tollsimy/LAITS-HW/Images/Screenshot_20220718_162311.png

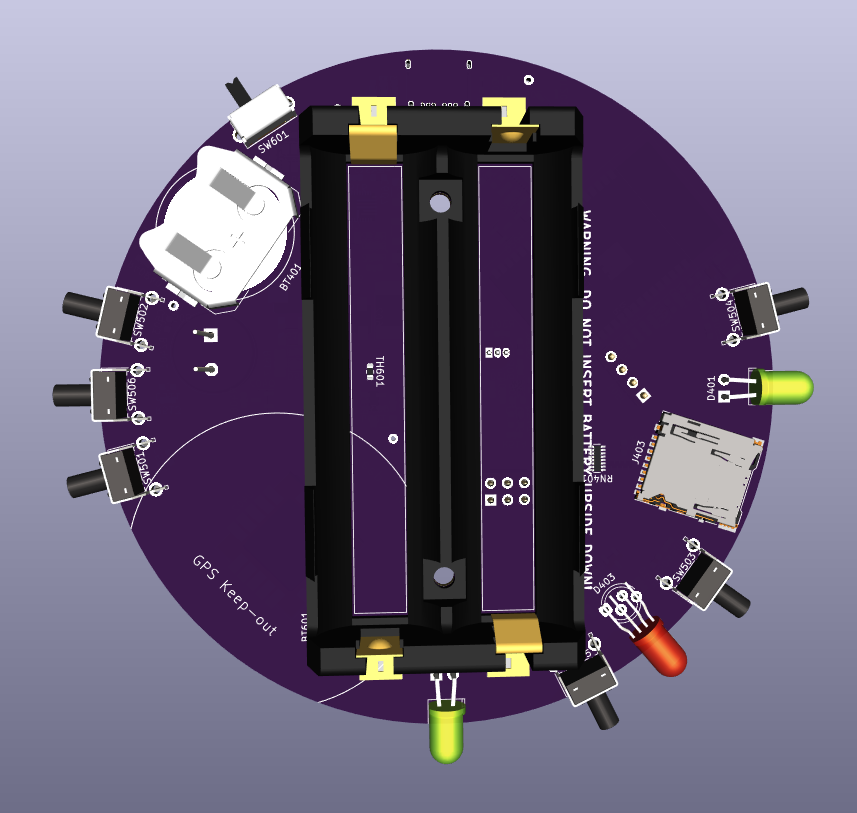
Images/Screenshot_20220718_162311.png
