tollsimy/LAITS-HW/datasheets/MAX_Priority_screen.png

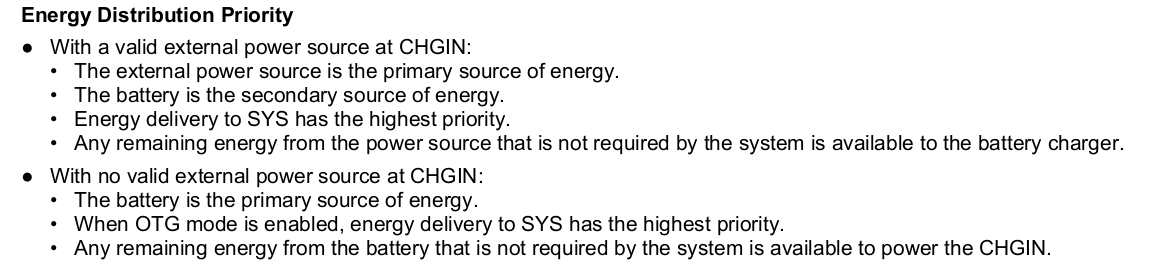
datasheets/MAX_Priority_screen.png
