tollsimy/LAITS-HW/datasheets/SX1503 screen 2.png

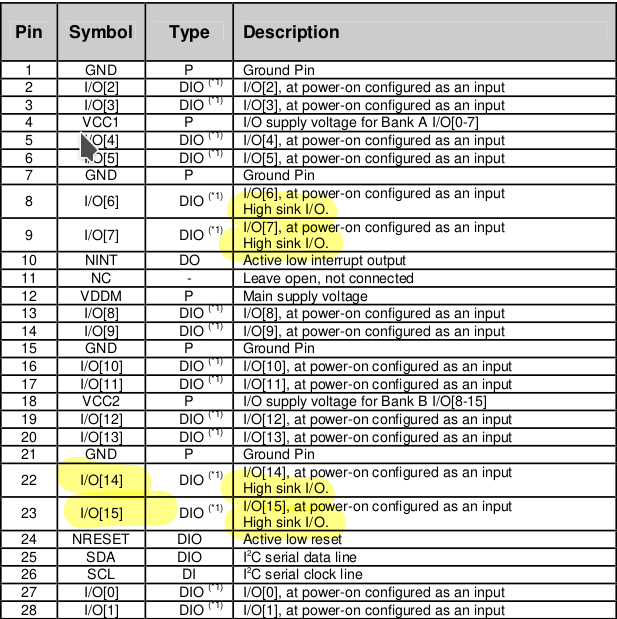
datasheets/SX1503 screen 2.png
