tollsimy/LAITS-HW/datasheets/SX1503 screen.png

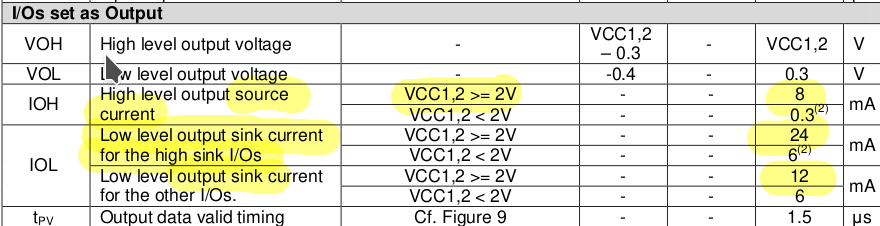
datasheets/SX1503 screen.png
