tollsimy/LAITS-HW/Images/Screenshot_20220715_111906.png

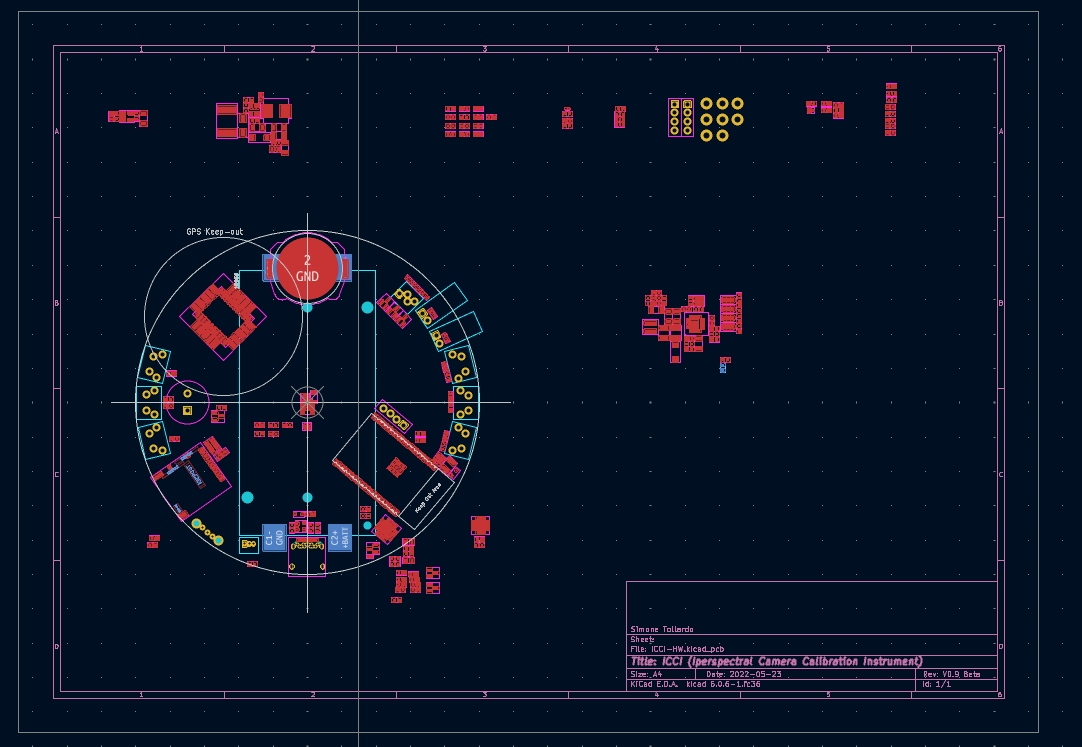
Images/Screenshot_20220715_111906.png
