tollsimy/LAITS-HW/Images/Screenshot_20220715_111938.png

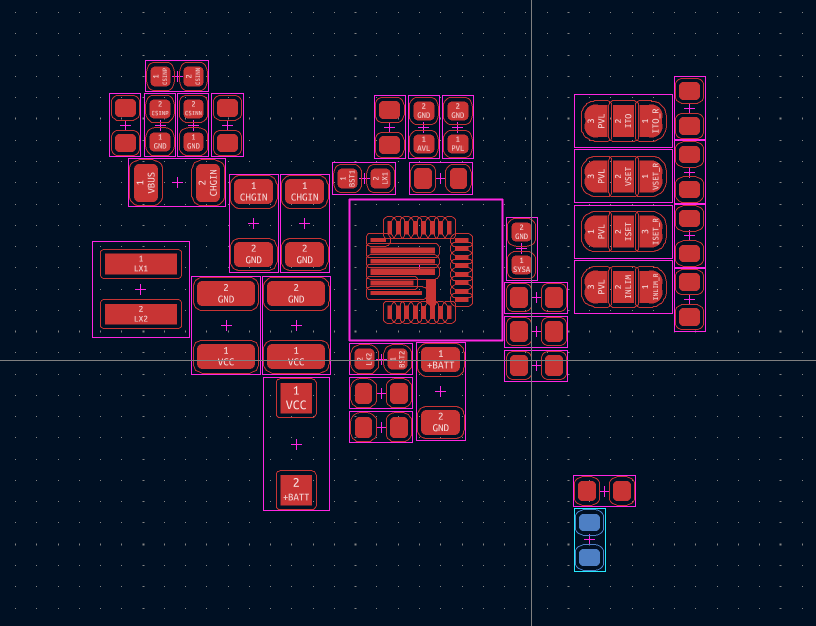
Images/Screenshot_20220715_111938.png
