tollsimy/LAITS-HW/Images/Screenshot_20220715_112000.png

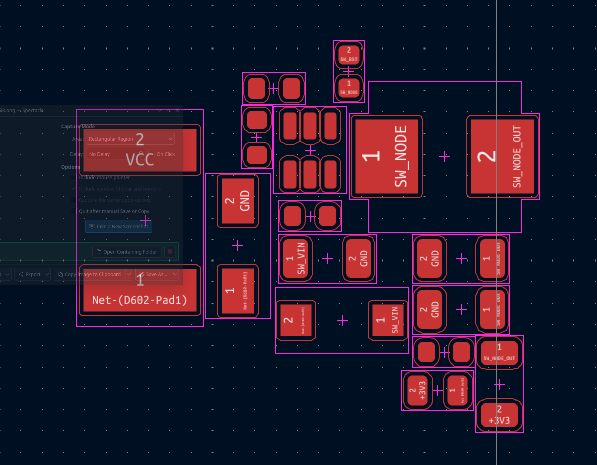
Images/Screenshot_20220715_112000.png
