tollsimy/LAITS-HW/Images/Screenshot_20220715_112012.png

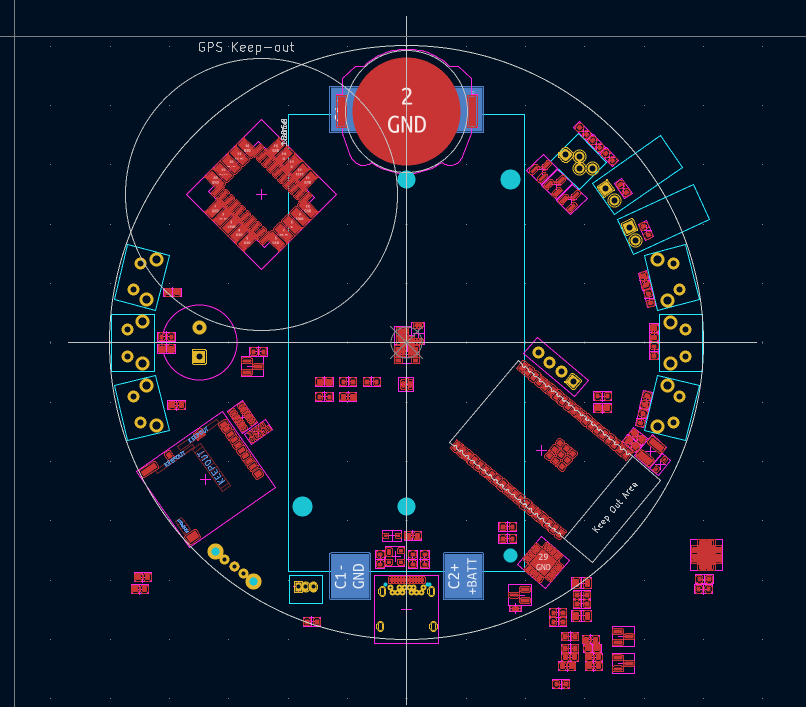
Images/Screenshot_20220715_112012.png
