tollsimy/LAITS-HW/Images/Screenshot_20220718_162223.png

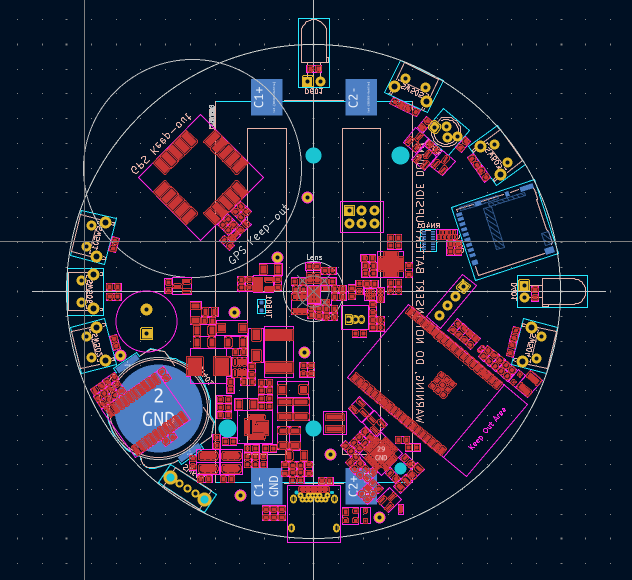
Images/Screenshot_20220718_162223.png
