tollsimy/LAITS-HW/Images/Screenshot_20220718_162258.png

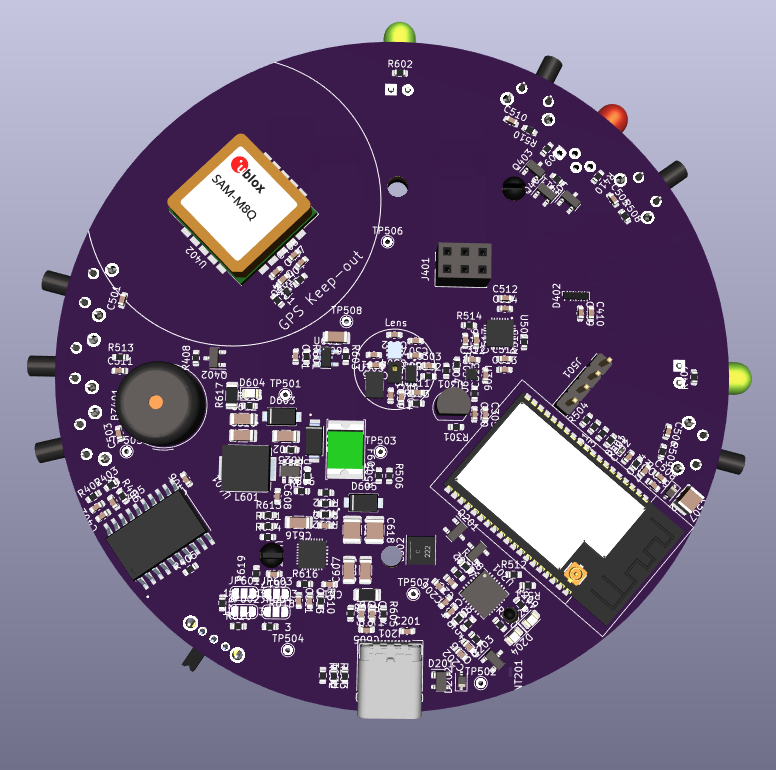
Images/Screenshot_20220718_162258.png
