tollsimy/LAITS-HW/Images/Screenshot_20220722_200650.png

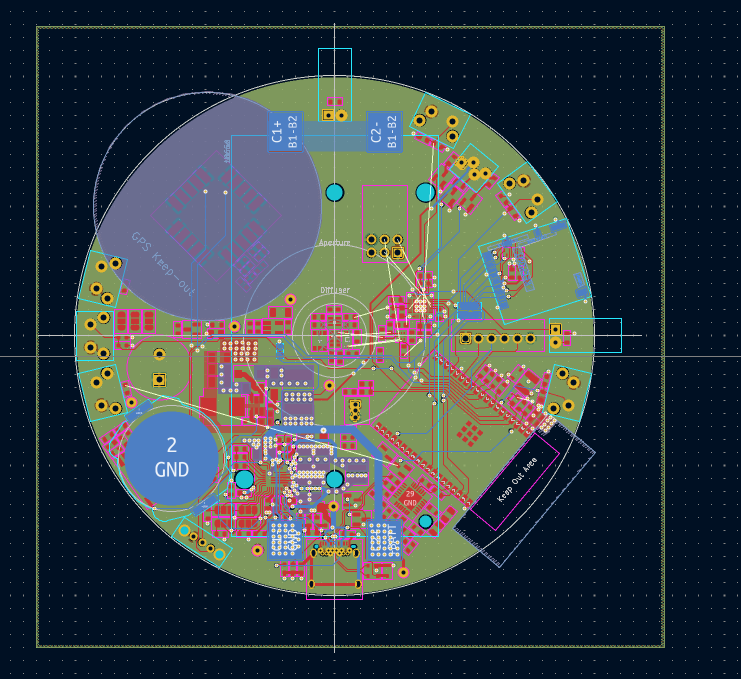
Images/Screenshot_20220722_200650.png
