tollsimy/LAITS-HW/Images/Screenshot_20220724_180053.png

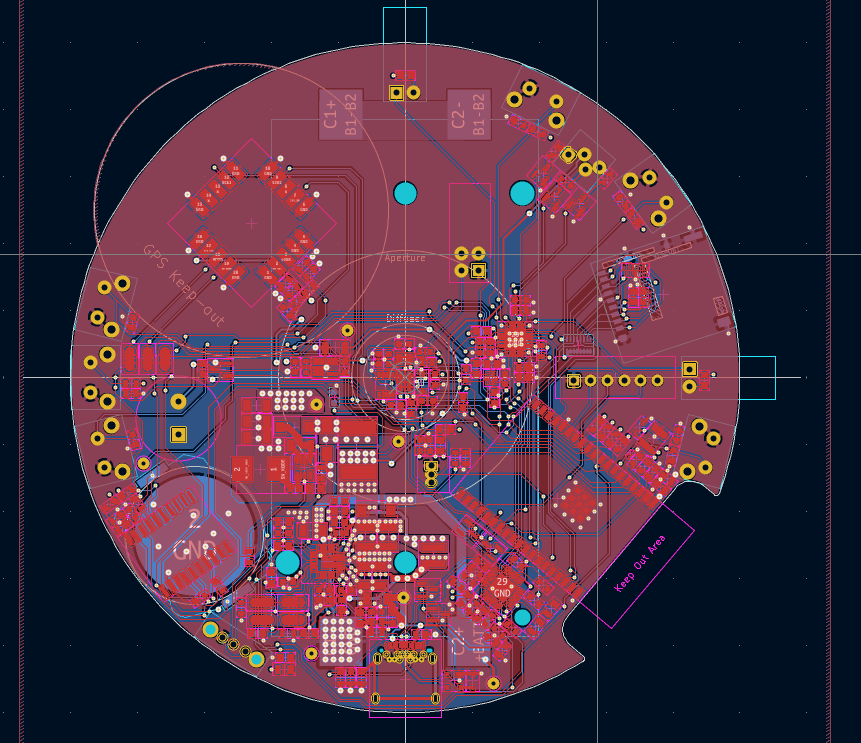
Images/Screenshot_20220724_180053.png
