tollsimy/LAITS-HW/Images/Screenshot_20220724_180108.png

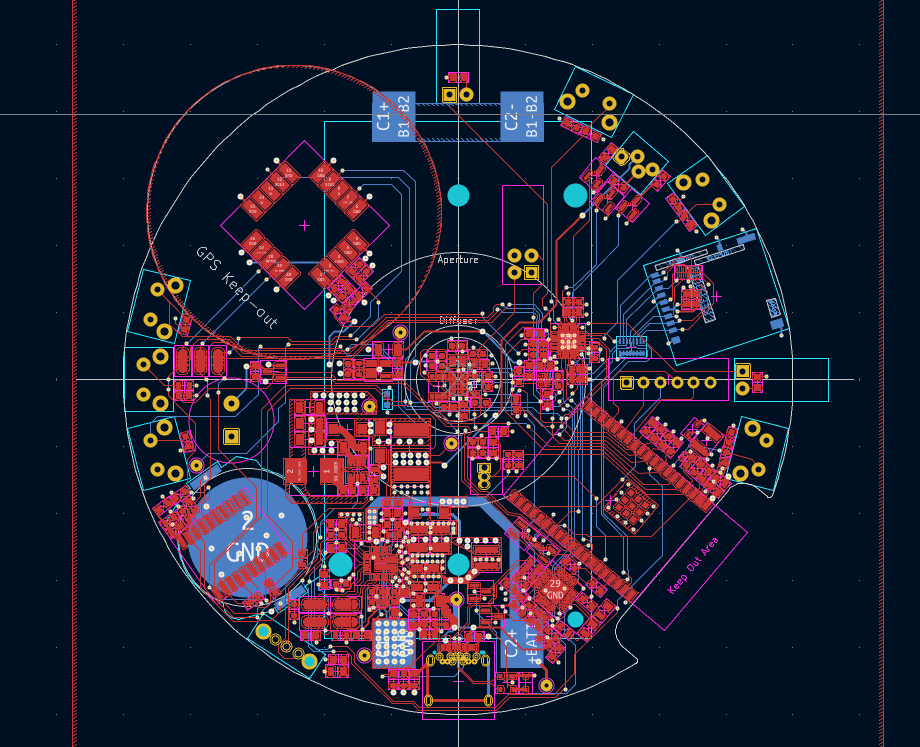
Images/Screenshot_20220724_180108.png
