tollsimy/LAITS-HW/Images/Screenshot_20220725_200332.png

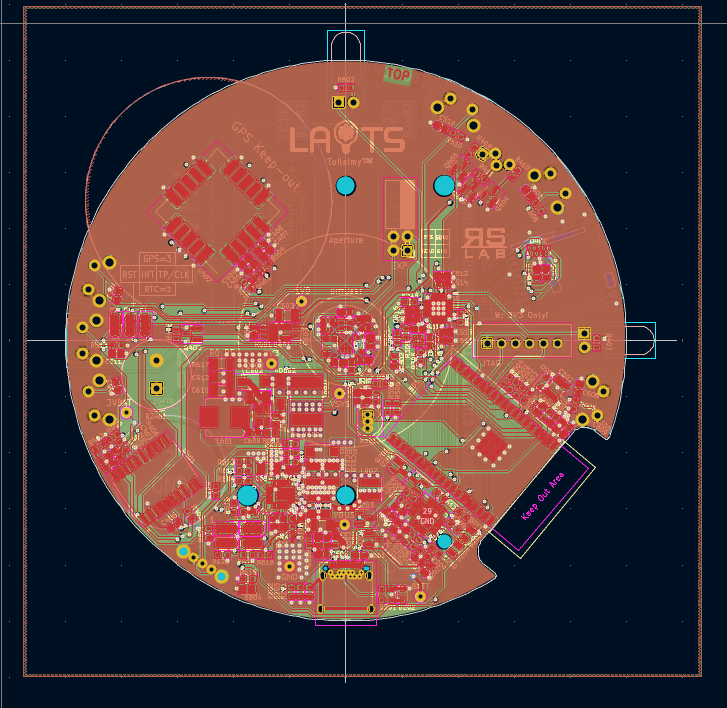
Images/Screenshot_20220725_200332.png
