tollsimy/LAITS-HW/Images/Screenshot_20220725_200348.png

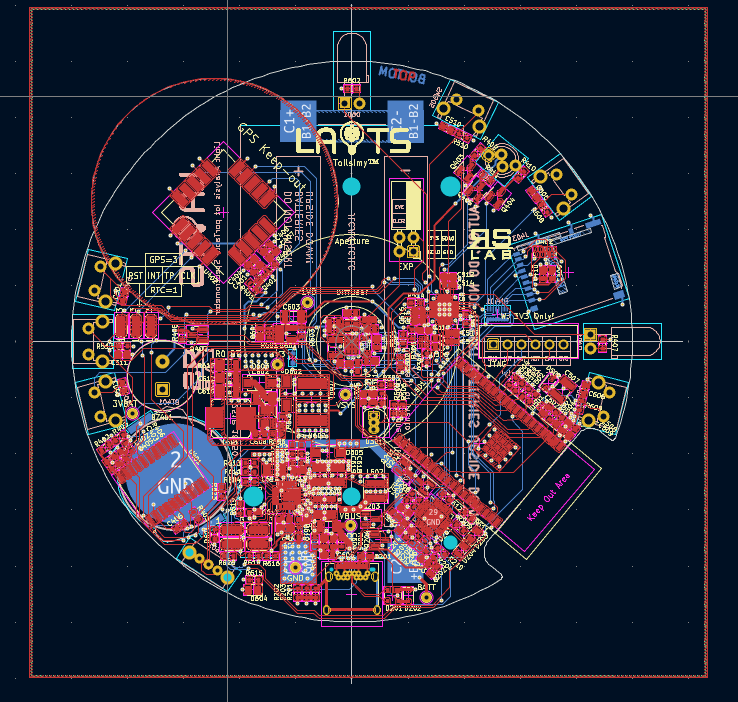
Images/Screenshot_20220725_200348.png
