tollsimy/LAITS-HW/LAITS-HW/LAITS_Edge_Cuts_round.dxf

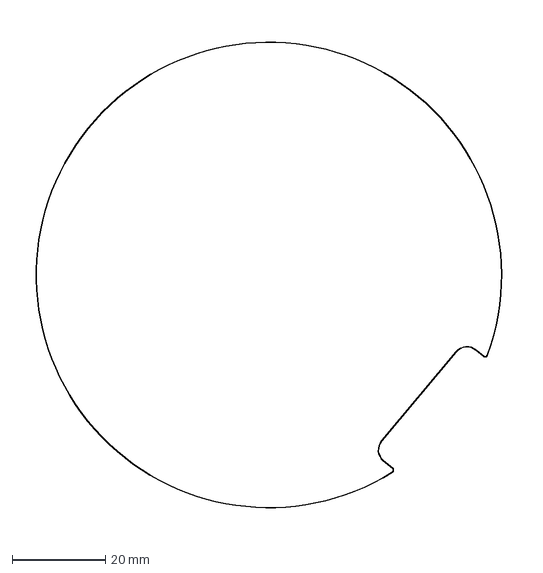
[picture p16: CAD file, 2022-07-25]
LAITS-HW/LAITS_Edge_Cuts_round.dxf
109.6 x 110.9 mm
