tollsimy/LAITS-HW/LAITS-HW/axies.dxf

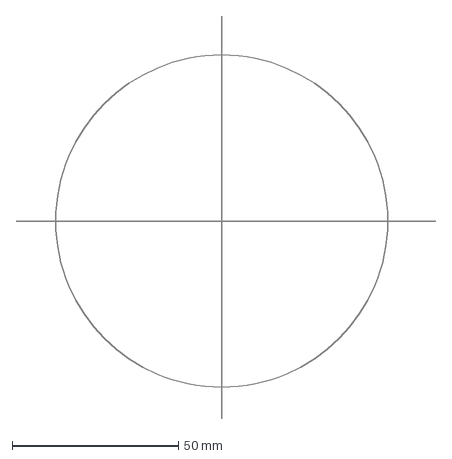
[picture p17: CAD file, 2022-07-15]
LAITS-HW/axies.dxf
126.3 x 121.2 mm
