tollsimy/LAITS-HW/Project Outputs/JLCPCB Instructions/Screenshot_20220727_115843.png

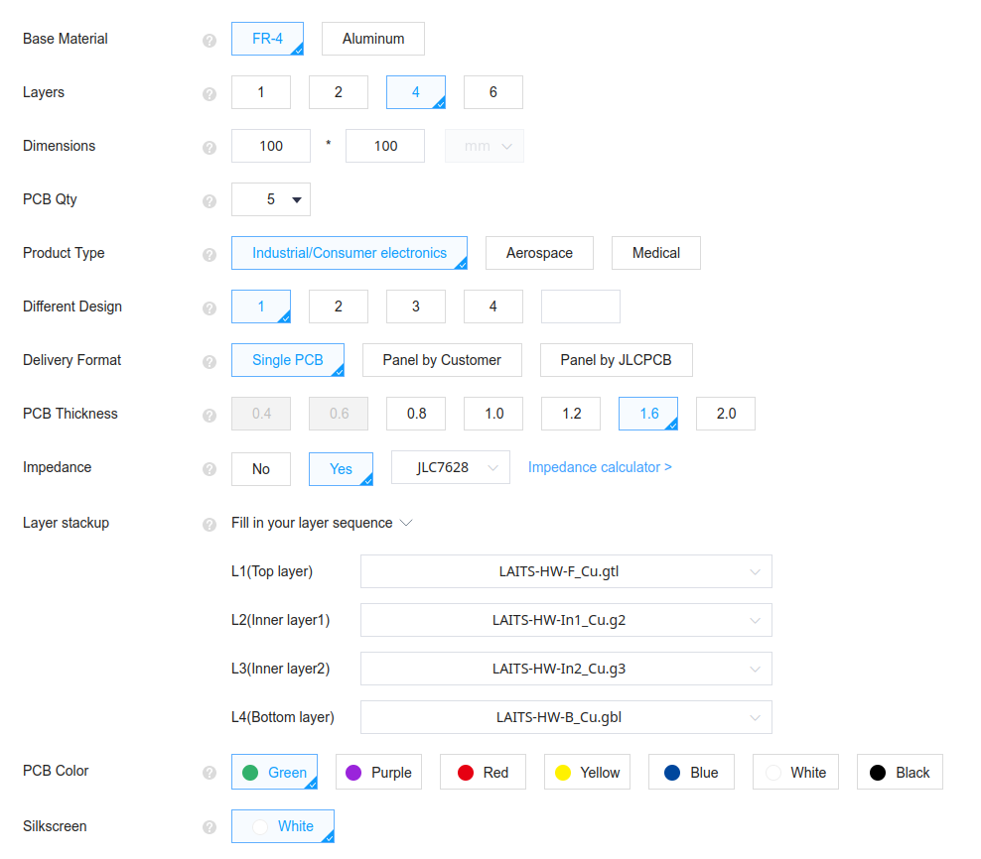
Project Outputs/JLCPCB Instructions/Screenshot_20220727_115843.png
