tollsimy/LAITS-HW/Project Outputs/JLCPCB Instructions/Screenshot_20220727_120037.png

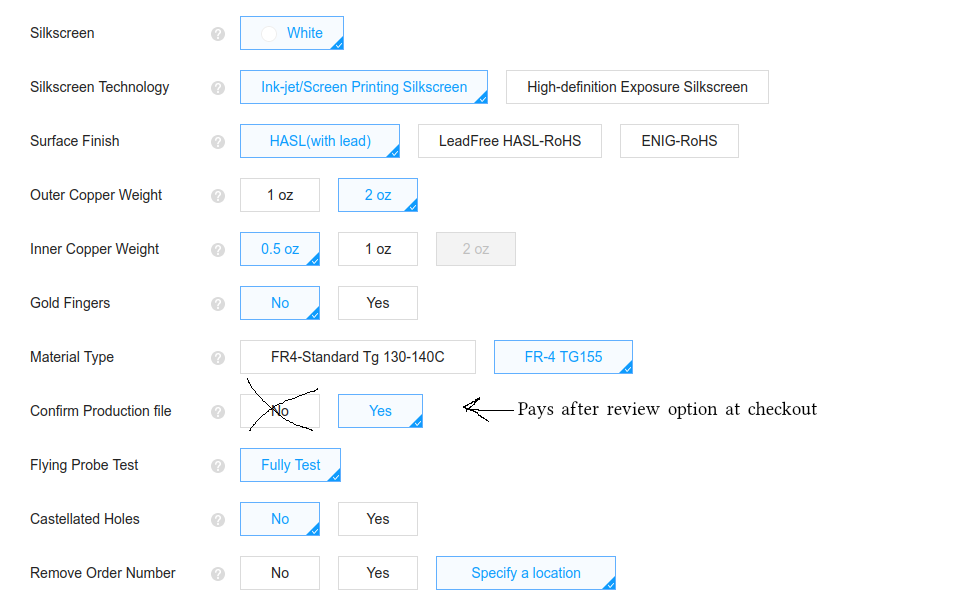
Project Outputs/JLCPCB Instructions/Screenshot_20220727_120037.png
