tollsimy/LAITS-HW/Project Outputs/JLCPCB Instructions/Screenshot_20220727_121014.png

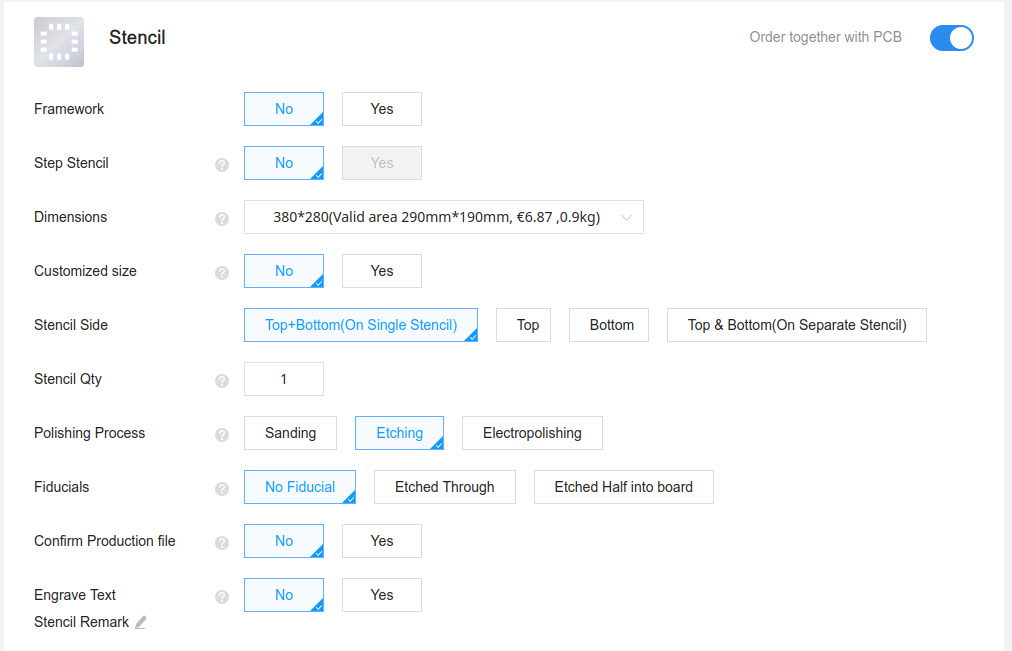
Project Outputs/JLCPCB Instructions/Screenshot_20220727_121014.png
