tollsimy/LAITS-HW/Project Outputs/LAITS-HW.pdf

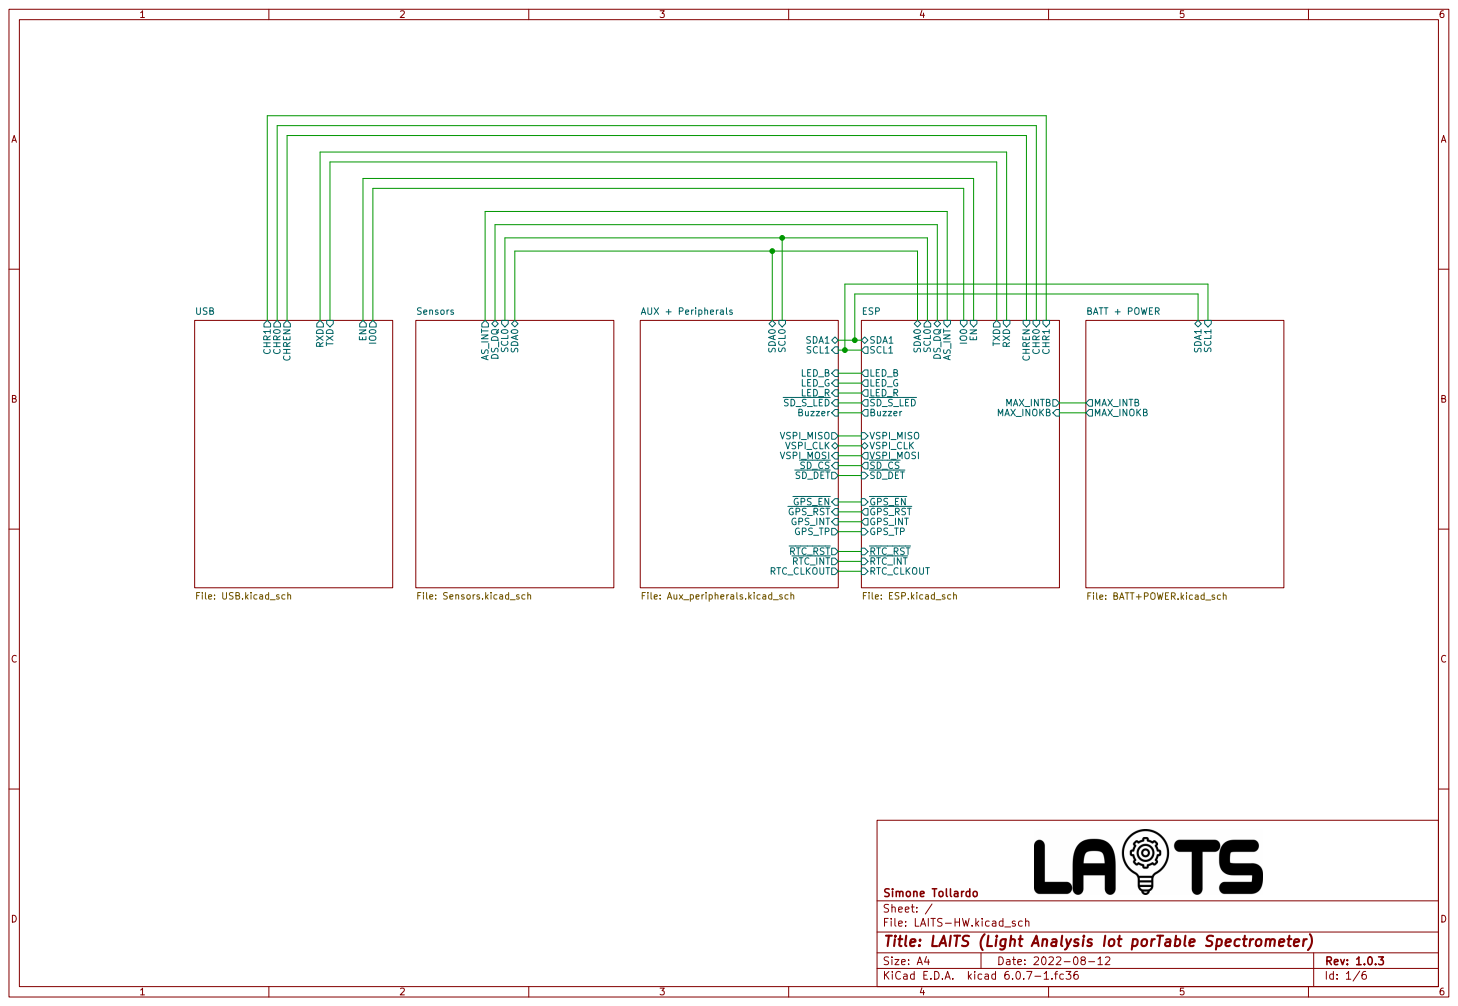
[picture p21: page 1]

AUX + Peripherals

BATT + POWER

File: LAITS-HW.kicad_sch Sheet: / Simone Tollardo

Id: 1/6 Title: LAITS (Light Analysis Iot porTable Spectrometer)

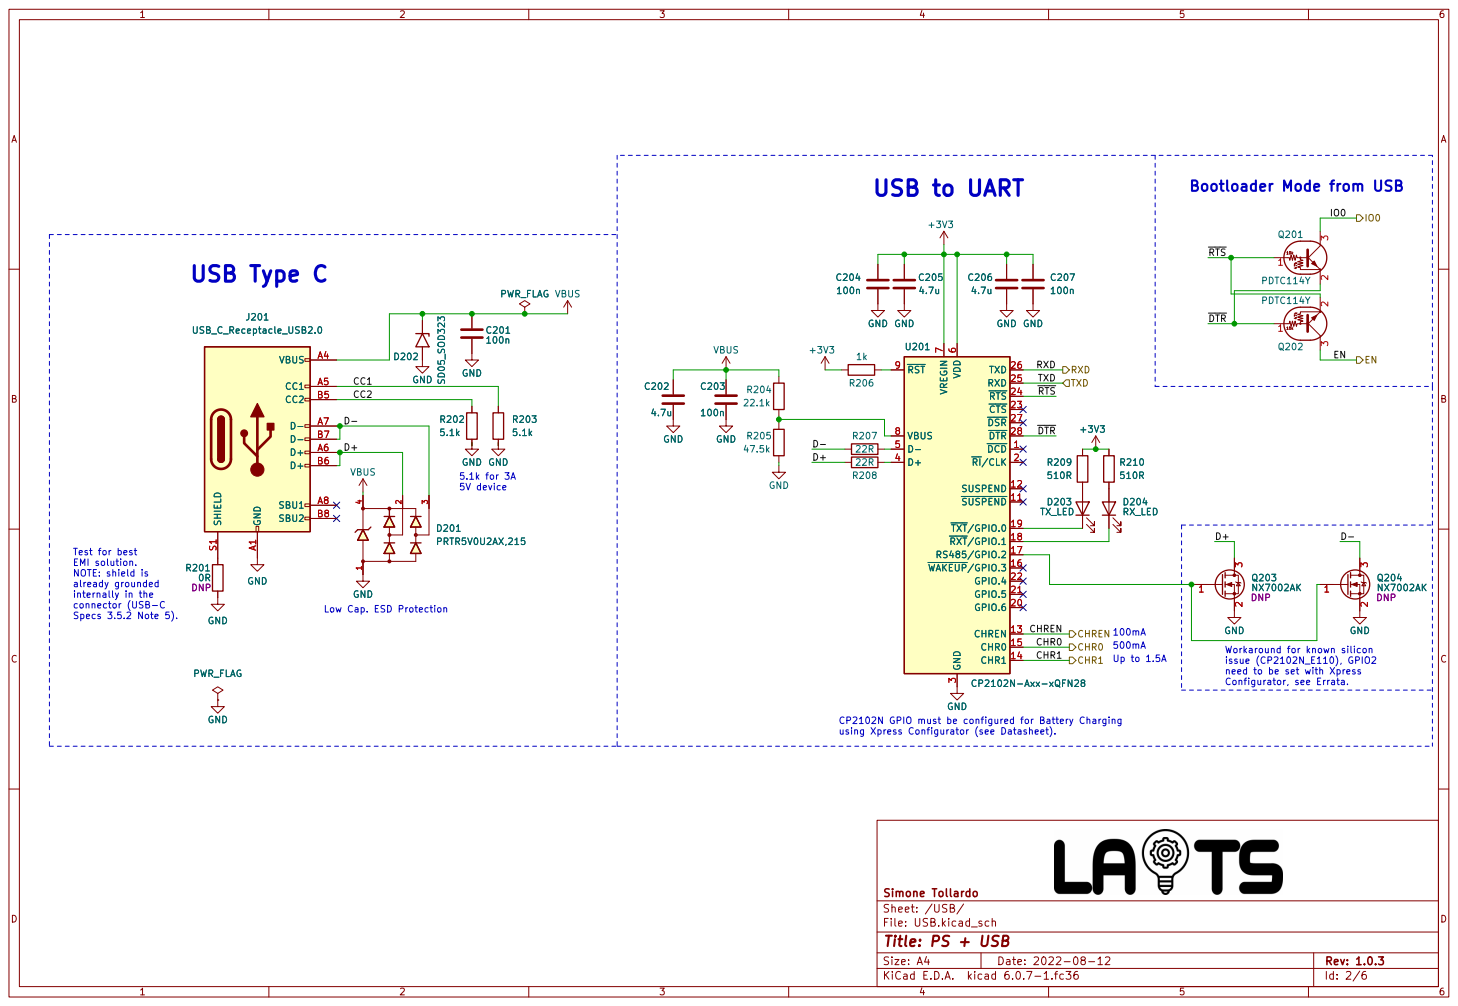
[picture p22: page 2]

Configurator, see Errata. Test for best EMI solution. NOTE: shield is already grounded

Low Cap. ESD Protection

issue (CP2102N_E110), GPIO2
need to be set with Xpress

CP2102N GPIO must be configured for Battery Charging
using Xpress Configurator (see Datasheet).

File: USB.kicad_sch Sheet: /USB/ Simone Tollardo

Id: 2/6 Title: PS + USB

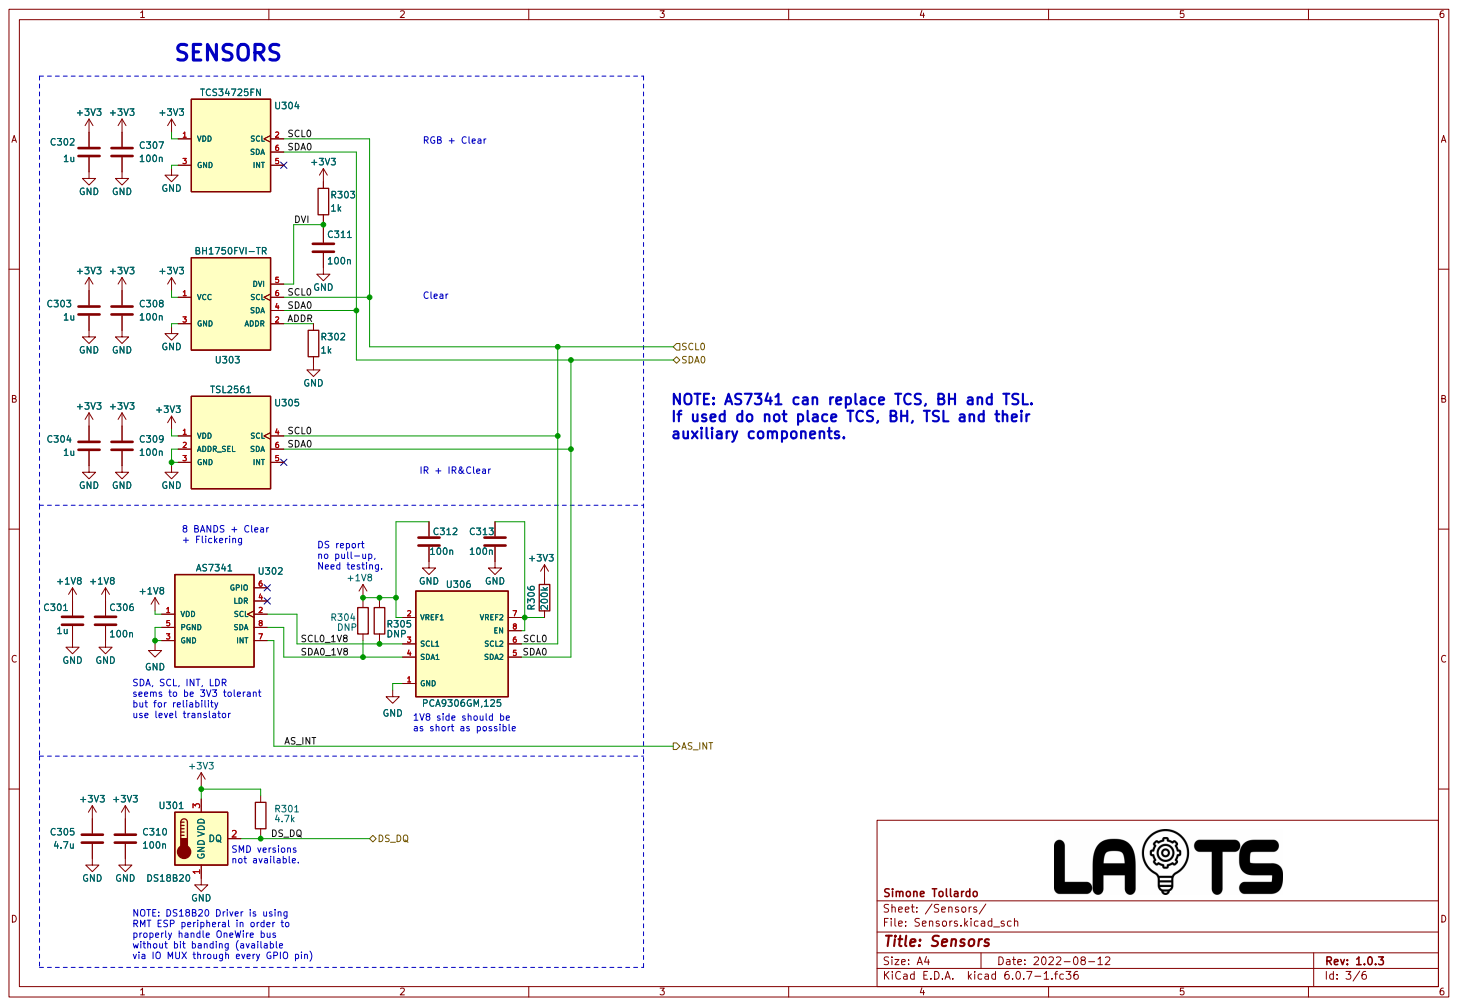
[picture p23: page 3]

IR + IR&Clear Clear RGB + Clear 8 BANDS + Clear + Flickering SDA, SCL, INT, LDR

NOTE: AS7341 can replace TCS, BH and TSL.
If used do not place TCS, BH, TSL and their
auxiliary components.

as short as possible

File: Sensors.kicad_sch Sheet: /Sensors/ Simone Tollardo GND

RMT ESP peripheral in order to
properly handle OneWire bus
without bit banding (available

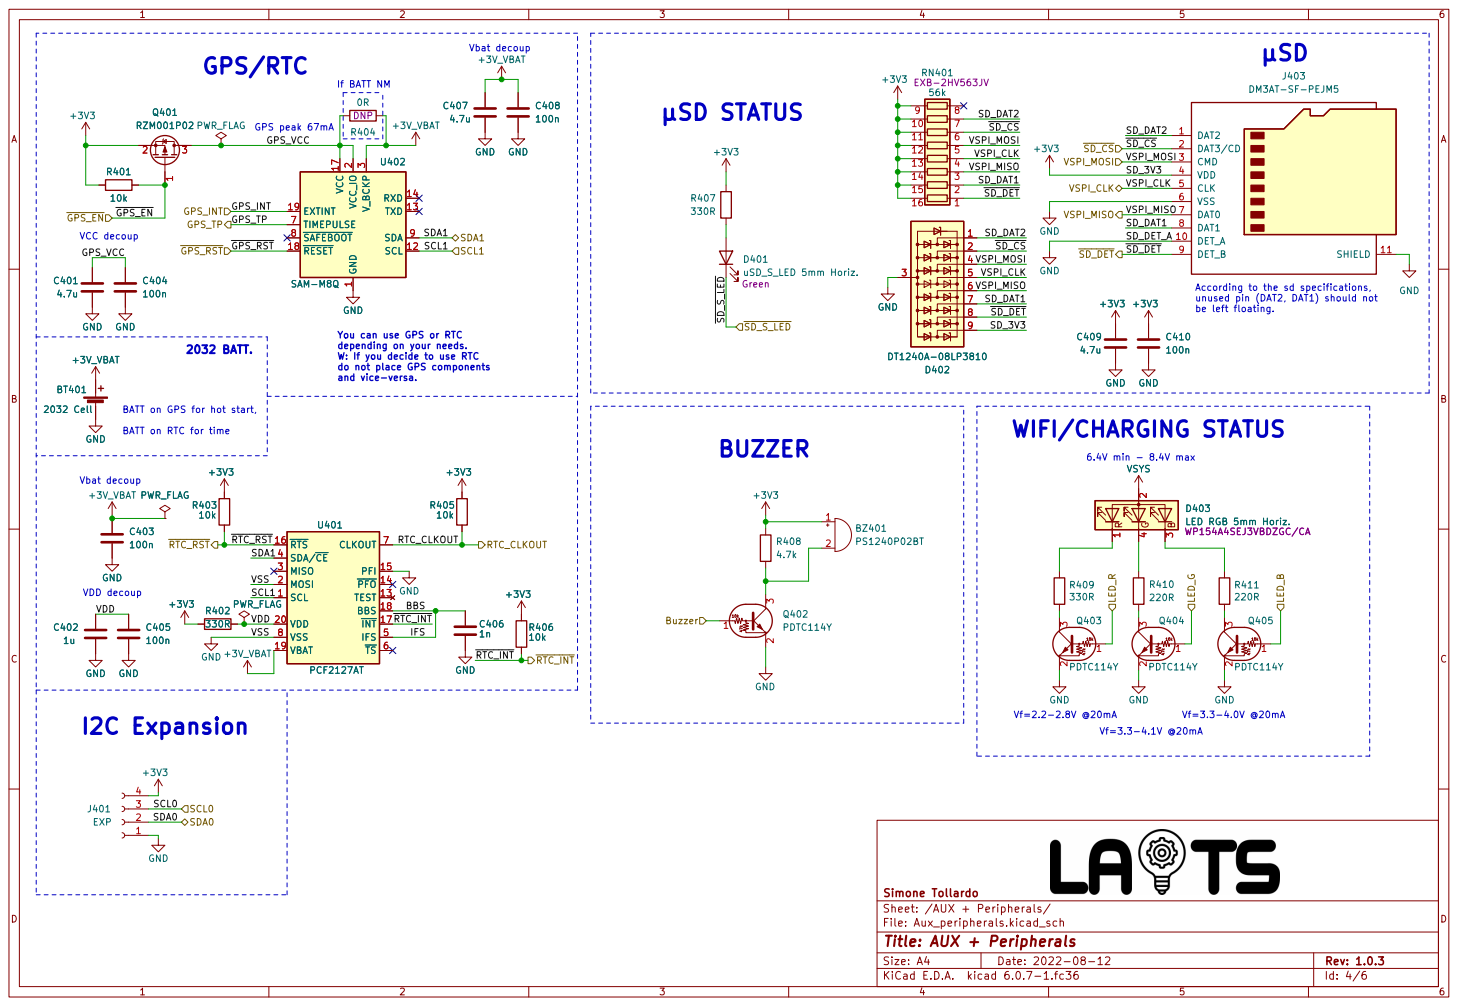
[picture p24: page 4]

3 TIMEPULSE 7 ~{SAFEBOOT} 8 SDA 9 GND GND

3 TIMEPULSE 7 ~{SAFEBOOT} 8 SDA 9 U402 SAM-M8Q

1 SCL 12 TXD 13 RXD VCC 14 17

Sheet: /AUX + Peripherals/ Simone Tollardo GND

unused pin (DAT2, DAT1) should not
be left floating.

depending on your needs.
W: If you decide to use RTC
do not place GPS components and vice-versa.

LED RGB 5mm Horiz. WP154A4SEJ3VBDZGC/CA R411

File: Aux_peripherals.kicad_sch
Id: 4/6 Title: AUX + Peripherals

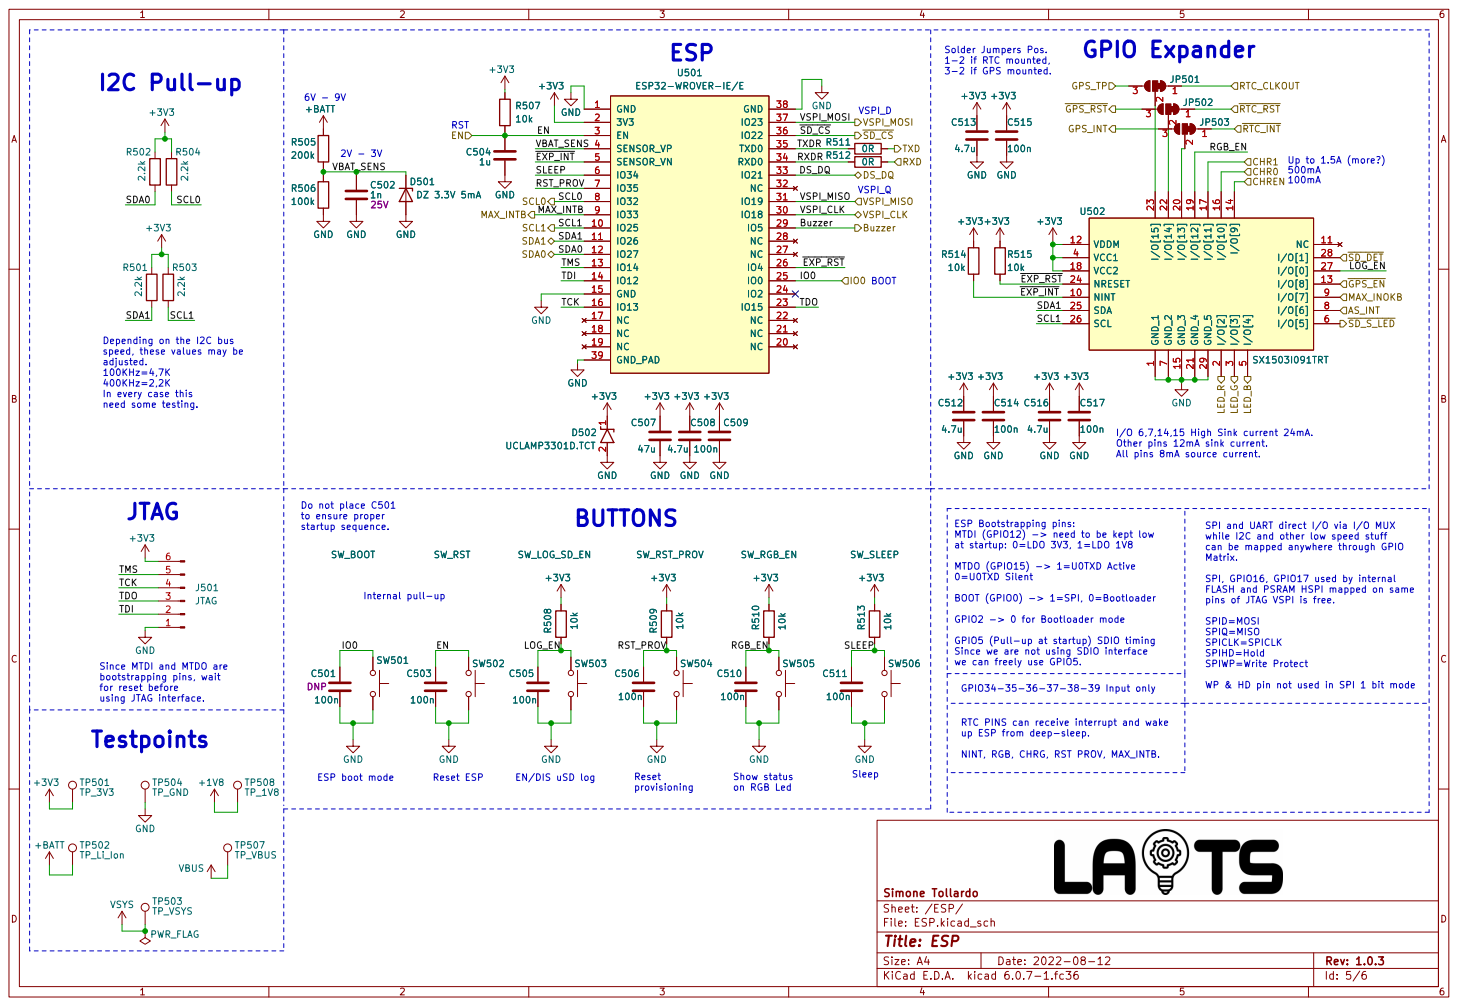
[picture p25: page 5]

Depending on the I2C bus
speed, these values may be
adjusted. 100KHz=4,7K

400KHz=2,2K
In every case this

I/O 6,7,14,15 High Sink current 24mA.
Other pins 12mA sink current.
All pins 8mA source current.

Do not place C501
to ensure proper startup sequence.

ESP Bootstrapping pins:
MTDI (GPIO12) -> need to be kept low
at startup: 0=LDO 3V3, 1=LDO 1V8

can be mapped anywhere through GPIO Matrix. SPI, GPIO16, GPIO17 used by internal

MTDO (GPIO15) -> 1=U0TXD Active
0=U0TXD Silent BOOT (GPIO0) -> 1=SPI, 0=Bootloader GPIO2 -> 0 for Bootloader mode GPIO5 (Pull-up at startup) SDIO timing

FLASH and PSRAM HSPI mapped on same
pins of JTAG VSPI is free. SPID=MOSI SPIQ=MISO

SPICLK=SPICLK
SPIHD=Hold SPIWP=Write Protect WP & HD pin not used in SPI 1 bit mode

Since we are not using SDIO interface

Since MTDI and MTDO are
bootstrapping pins, wait
for reset before
using JTAG interface.
Testpoints

RTC PINS can receive interrupt and wake up ESP from deep-sleep. NINT, RGB, CHRG, RST PROV, MAX_INTB.

+3V3 | TP502 TP_Li_Ion TP501 TP_3V3 +BATT | TP503 TP_VSYS PWR_FLAG

Show status on RGB Led Reset provisioning

File: ESP.kicad_sch Sheet: /ESP/ Simone Tollardo

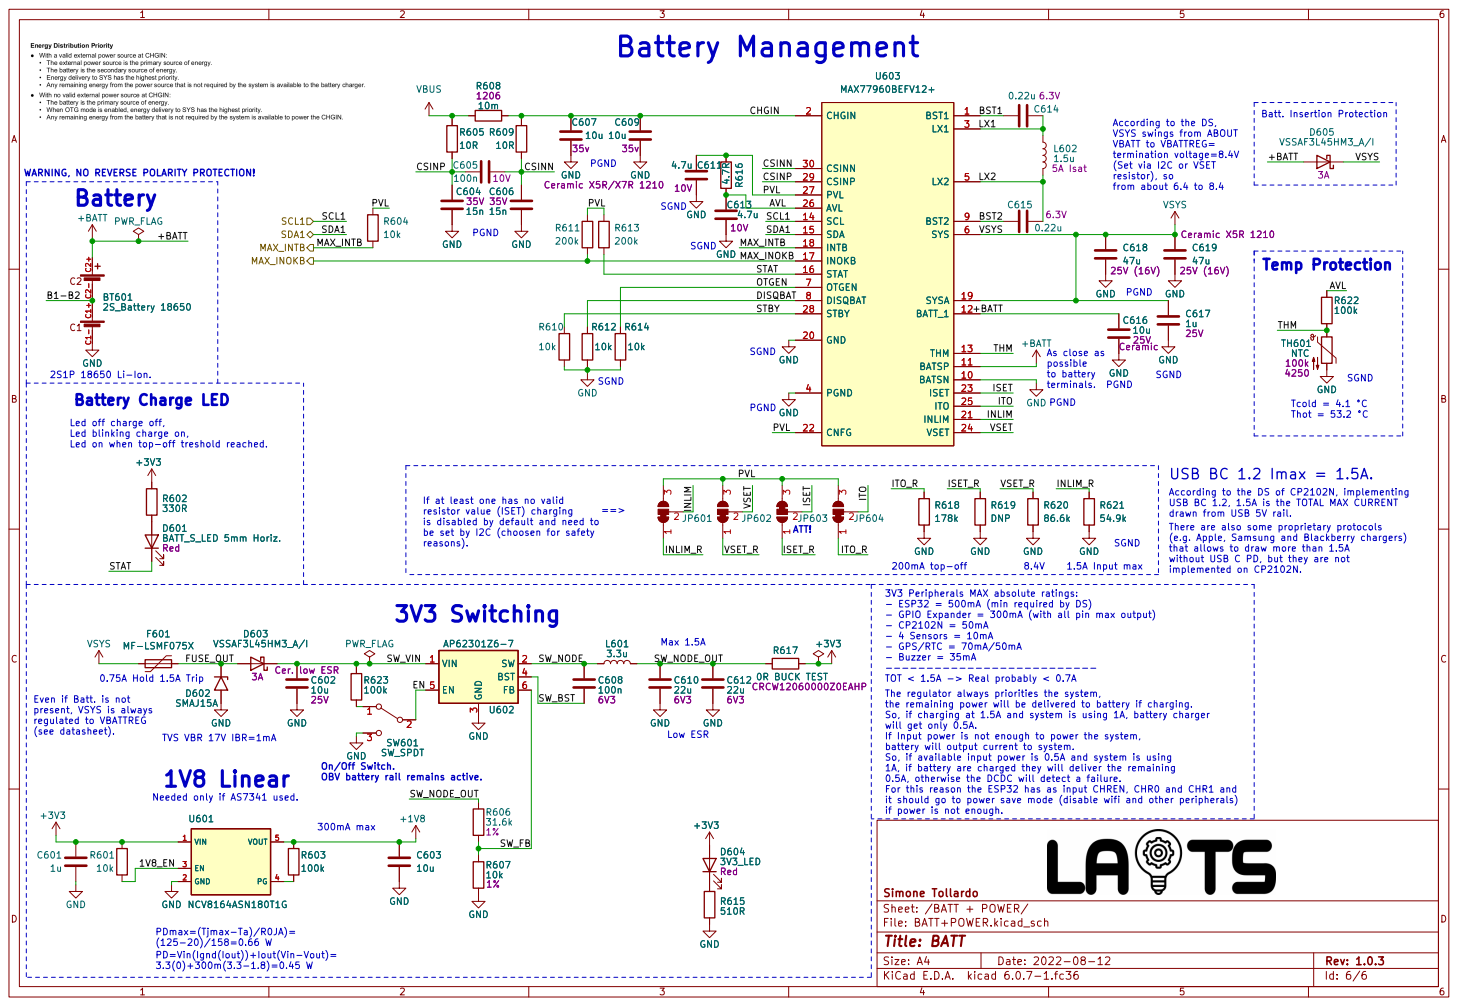
[picture p26: page 6]

Batt. Insertion Protection PGND
VSYS swings from ABOUT VBATT to VBATTREG=

termination voltage=8.4V
(Set via I2C or VSET
resistor), so

from about 6.4 to 8.4 PGND

drawn from USB 5V rail.Temp Protection

As close as possible

terminals. On/Off Switch. OBV battery rail remains active.

300mA max Battery Charge LED
Led off charge off,
Led blinking charge on,
Led on when top-off treshold reached.

If at least one has no valid
resistor value (ISET) charging
is disabled by default and need to
be set by I2C (choosen for safety
reasons).

According to the DS of CP2102N, implementing USB BC 1.2, 1.5A is the TOTAL MAX CURRENT

There are also some proprietary protocols
(e.g. Apple, Samsung and Blackberry chargers)
that allows to draw more than 1.5A without USB C PD, but they are not

1.5A Input max Low ESR

3V3 Peripherals MAX absolute ratings:
- ESP32 = 500mA (min required by DS)
- GPIO Expander = 300mA (with all pin max output)
- 4 Sensors = 10mA
- GPS/RTC = 70mA/50mA
- Buzzer = 35mA
-------------------------- TOT < 1.5A -> Real probably < 0.7A

if power is not enough. Max 1.5A

25V Cer. low ESR GND
100k GND

Even if Batt. is not present, VSYS is always

The regulator always priorities the system,
the remaining power will be delivered to battery if charging.
So, if charging at 1.5A and system is using 1A, battery charger
will get only 0.5A.
If Input power is not enough to power the system,
battery will output current to system.
So, if available input power is 0.5A and system is using
1A, if battery are charged they will deliver the remaining
0.5A, otherwise the DCDC will detect a failure. For this reason the ESP32 has as input CHREN, CHR0 and CHR1 and

Needed only if AS7341 used.

it should go to power save mode (disable wifi and other peripherals)

File: BATT+POWER.kicad_sch Sheet: /BATT + POWER/ Simone Tollardo

PDmax=(Tjmax-Ta)/R0JA)=
PD=Vin(Ignd(Iout))+Iout(Vin-Vout)=
