tollsimy/LAITS-HW/ICCI-HW/ICCI-HW.kicad_pcb

## KiCad design ICCI-HW/ICCI-HW.kicad_pcb (2022-07-23)

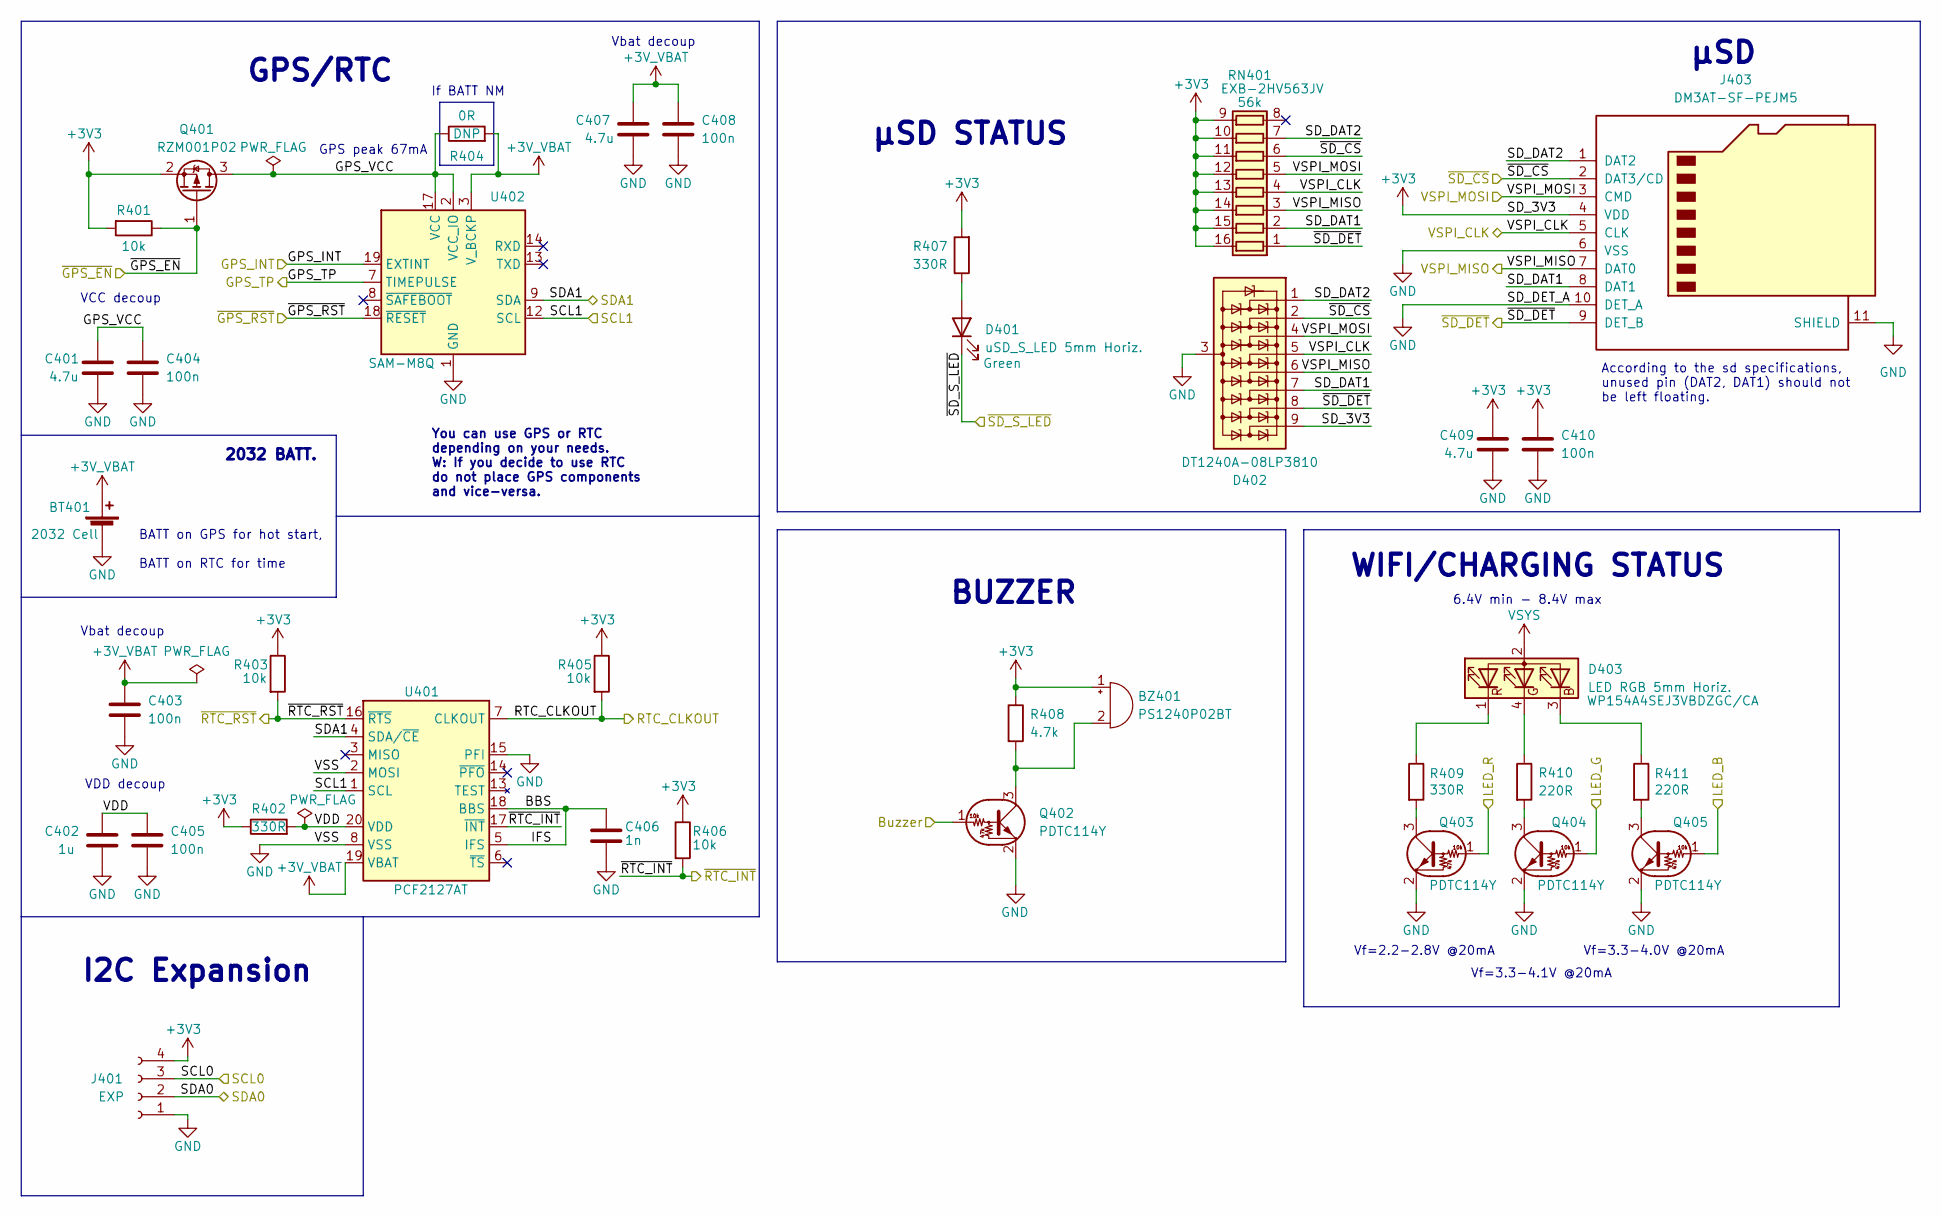
[picture p37: schematic Aux_peripherals.kicad_sch, AUX + Peripherals]

Parts:
BT401: 2032 Cell; BatteryHolder_Keystone_3034_1x20mm
BZ401: PS1240P02BT; Buzzer_TDK_PS1240P02BT_D12.2mm_H6.5mm
C401, C407, C409: 4.7u; C_0603_1608Metric
C402: 1u; C_0603_1608Metric
C403, C404, C405, C408, C410: 100n; C_0603_1608Metric
C406: 1n; C_0603_1608Metric
D401: uSD_S_LED 5mm Horiz.; LED_D5.0mm_Horizontal_O3.81mm_Z3.0mm
D402: DT1240A-08LP3810; LAITS_UDFN-9_1.0x3.8mm_P0.5mm
D403: LED RGB 5mm Horiz.; LED_D5.0mm-4_RGB_Staggered_Pins_Horizontal
J401: EXP; PinSocket_2x02_P2.54mm_Horizontal
J403: DM3AT-SF-PEJM5; LAITS_microSD_HC_Hirose_DM3AT-SF-PEJM5
Q401: RZM001P02
Q402, Q403, Q404, Q405: PDTC114Y; SOT-23
R401, R403, R405, R406: 10k; R_0603_1608Metric
R402, R407, R409: 330R; R_0603_1608Metric
R404: 0R; R_0603_1608Metric
R408: 4.7k; R_0603_1608Metric
R410, R411: 220R; R_0603_1608Metric
RN401: 56k; R_Array_Convex_8x0602
U401: PCF2127AT
U402: SAM-M8Q; LAITS_ublox_SAM-M8Q

Connections:
+3V0: BT401.1 (+), C403.1, C407.1, C408.1, R404.2, U401.19 (VBAT), U402.3 (V_BCKP); also elsewhere on the board
+3V3: BZ401.1 (-), C409.1, C410.1, D402.9 (K8), J401.4, J403.4 (VDD), Q401.2 (S), R401.2, R402.1, R403.1, R405.1, R406.1, R407.2, R408.1, RN401.9 (R8.2), RN401.10 (R7.2), RN401.11 (R6.2), RN401.12 (R5.2), RN401.13 (R4.2), RN401.14 (R3.2), RN401.15 (R2.2), RN401.16 (R1.2); also elsewhere on the board
/AUX + Peripherals/BBS: C406.1, U401.5 (IFS), U401.18 (BBS)
/AUX + Peripherals/GPS_EXTINT: U402.19 (EXTINT); also elsewhere on the board
/AUX + Peripherals/GPS_TP: U402.7 (TIMEPULSE); also elsewhere on the board
/AUX + Peripherals/GPS_VCC: C401.1, C404.1, Q401.3 (D), R404.1, U402.2 (VCC_IO), U402.17 (VCC)
/AUX + Peripherals/LED_B: Q405.1 (B); also elsewhere on the board
/AUX + Peripherals/LED_G: Q404.1 (B); also elsewhere on the board
/AUX + Peripherals/LED_R: Q403.1 (B); also elsewhere on the board
/AUX + Peripherals/RTC_CLKOUT: R405.2, U401.7 (CLKOUT); also elsewhere on the board
/AUX + Peripherals/SCL0: J401.3; also elsewhere on the board
/AUX + Peripherals/SCL1: U401.1 (SCL), U402.12 (SCL); also elsewhere on the board
/AUX + Peripherals/SDA0: J401.2; also elsewhere on the board
/AUX + Peripherals/SDA1: U401.4 (SDA/~CE), U402.9 (SDA); also elsewhere on the board
/AUX + Peripherals/SD_DAT1: D402.7 (K6), J403.8 (DAT1), RN401.2 (R2.1)
/AUX + Peripherals/SD_DAT2: D402.1 (K1), J403.1 (DAT2), RN401.7 (R7.1)
/AUX + Peripherals/VDD: C402.1, C405.1, R402.2, U401.20 (VDD)
/AUX + Peripherals/VSPI_CLK: D402.5 (K4), J403.5 (CLK), RN401.4 (R4.1); also elsewhere on the board
/AUX + Peripherals/VSPI_MISO: D402.6 (K5), J403.7 (DAT0), RN401.3 (R3.1); also elsewhere on the board
/AUX + Peripherals/VSPI_MOSI: D402.4 (K3), J403.3 (CMD), RN401.5 (R5.1); also elsewhere on the board
/AUX + Peripherals/~GPS_EN: Q401.1 (G), R401.1; also elsewhere on the board
/AUX + Peripherals/~GPS_RESET: U402.18 (~RESET); also elsewhere on the board
/AUX + Peripherals/~RTC_INT: R406.2, U401.17 (~INT); also elsewhere on the board
/AUX + Peripherals/~RTC_RST: R403.2, U401.16 (~RTS); also elsewhere on the board
/AUX + Peripherals/~SD_CS: D402.2 (K2), J403.2 (DAT3/CD), RN401.6 (R6.1); also elsewhere on the board
/AUX + Peripherals/~SD_DET: D402.8 (K7), J403.9 (DET_B), RN401.1 (R1.1); also elsewhere on the board
/AUX + Peripherals/~SD_S_LED: D401.1 (K); also elsewhere on the board
/ESP/Buzzer: Q402.1 (B); also elsewhere on the board
GND: BT401.2 (-), C401.2, C402.2, C403.2, C404.2, C405.2, C406.2, C407.2, C408.2, C409.2, C410.2, D402.3 (A), J401.1, J403.6 (VSS), J403.10 (DET_A), J403.11 (SHIELD), Q402.2 (E), Q403.2 (E), Q404.2 (E), Q405.2 (E), U401.2 (MOSI), U401.8 (VSS), U401.15 (PFI), U402.1 (GND), U402.4 (GND), U402.5 (GND), U402.6 (GND), U402.10 (GND), U402.11 (GND), U402.15 (GND), U402.16 (GND), U402.20 (GND); also elsewhere on the board
unnamed: BZ401.2 (+), Q402.3 (C), R408.2
unnamed: D401.2 (A), R407.1
unnamed: D403.1 (RK), R409.1
unnamed: D403.3 (BK), R411.1
unnamed: D403.4 (GK), R410.1
unnamed: Q403.3 (C), R409.2
unnamed: Q404.3 (C), R410.2
unnamed: Q405.3 (C), R411.2

Notes on the sheet:
VCC decoup
Vbat decoup
GPS/RTC
According to the sd specifications, unused pin (DAT2, DAT1) should not be left floating.
You can use GPS or RTC depending on your needs. W: If you decide to use RTC do not place GPS components and vice-versa.
BUZZER
I2C Expansion
6.4V min - 8.4V max
Vf=2.2-2.8V @20mA
If BATT NM
BATT on GPS for hot start, BATT on RTC for time
GPS peak 67mA
μSD STATUS
VDD decoup
Vf=3.3-4.1V @20mA
2032 BATT.
Vf=3.3-4.0V @20mA
WIFI/CHARGING STATUS
μSD

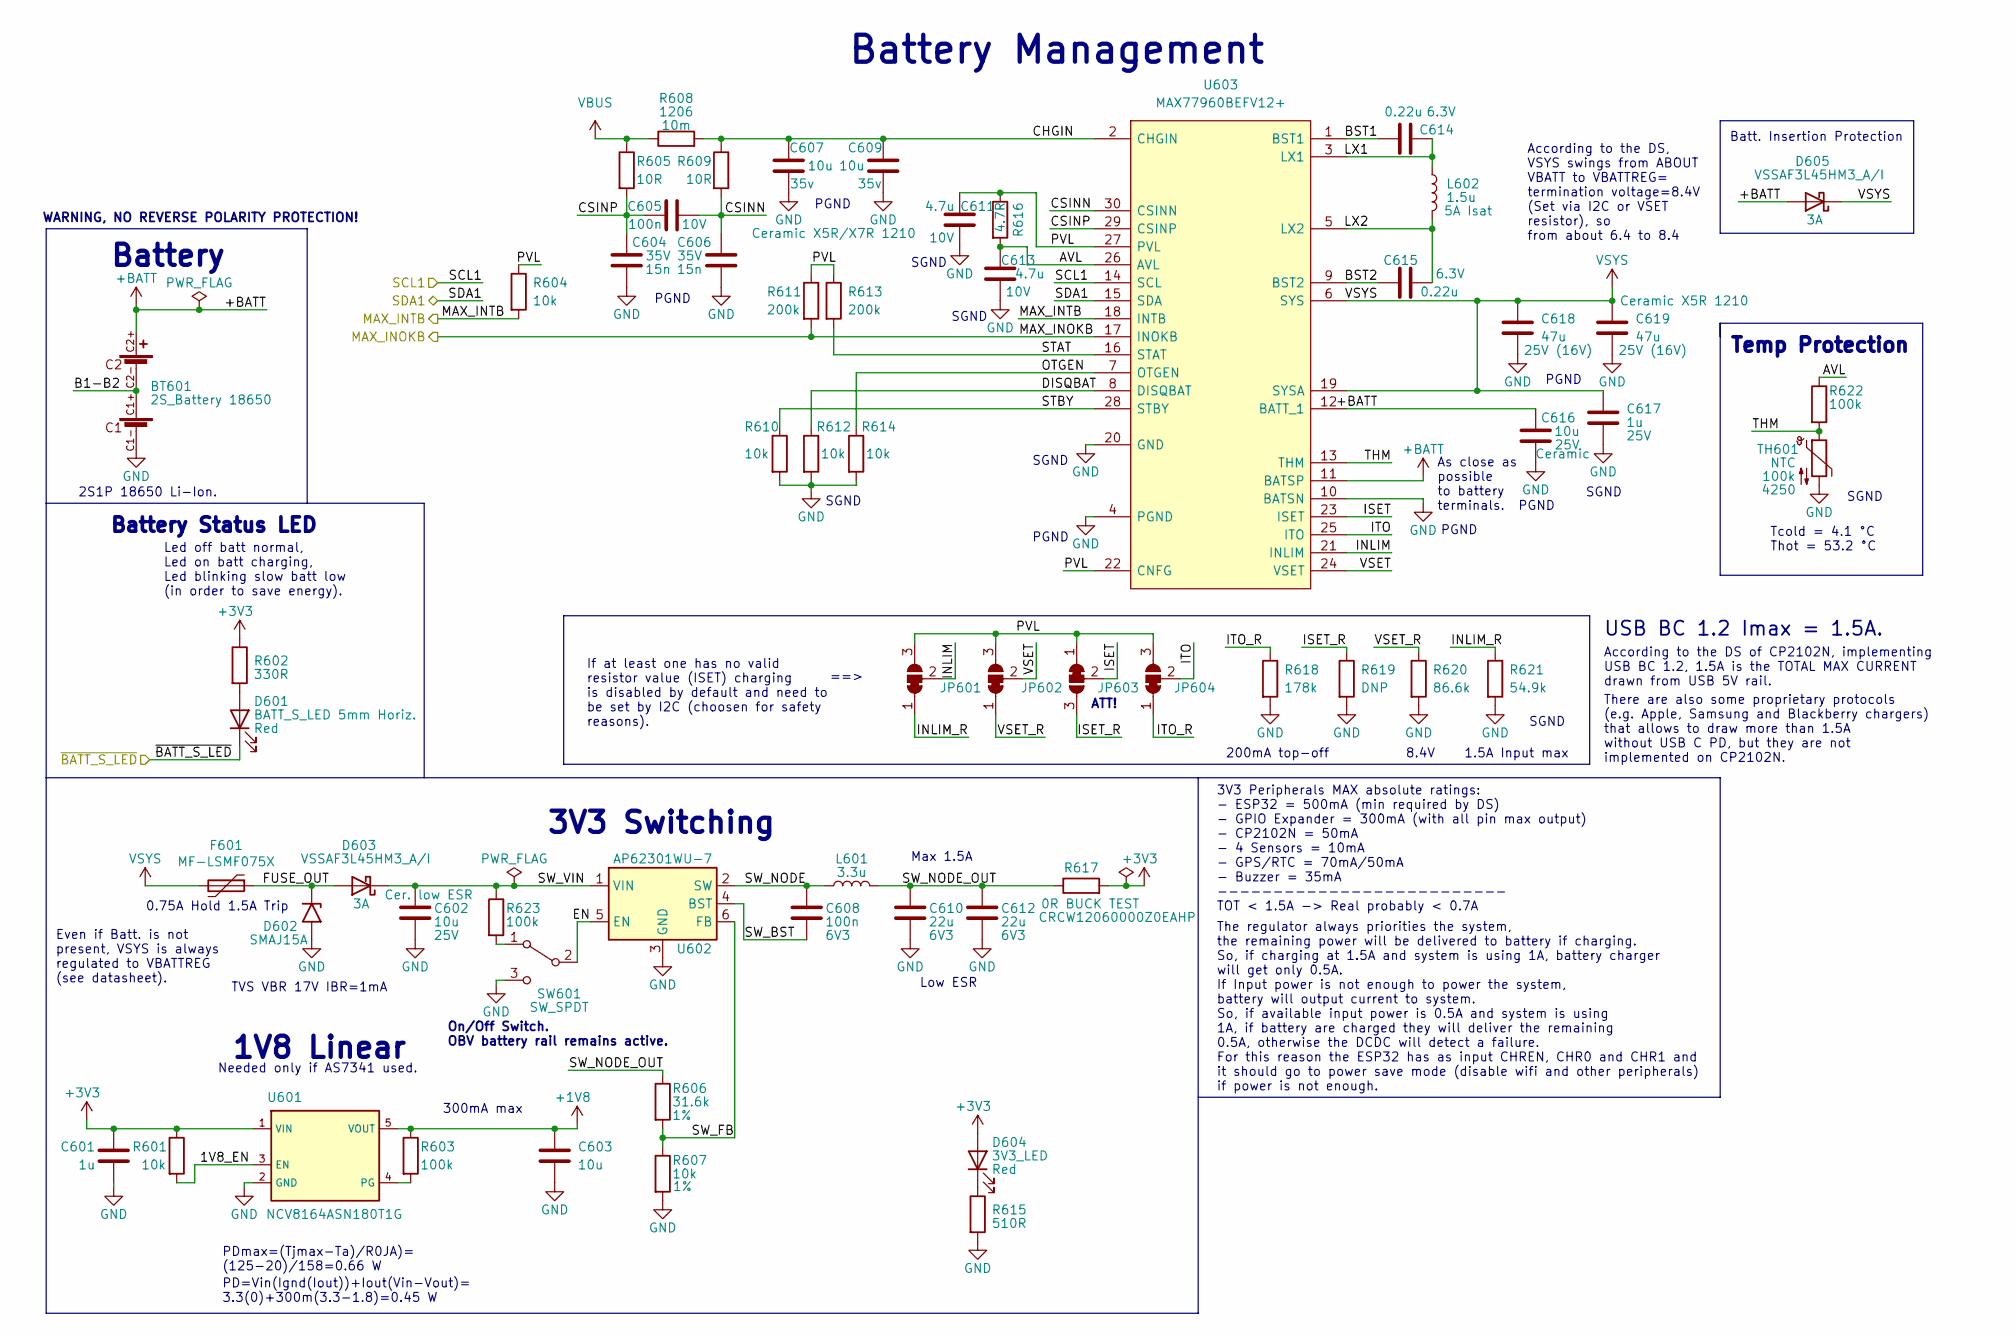
[picture p38: schematic BATT+POWER.kicad_sch, BATT]

Parts:
BT601: 2S_Battery 18650; BAT_1048
C601: 1u; C_0603_1608Metric
C602, C616: 10u; C_1206_3216Metric; Voltage 25V
C603: 10u; C_1206_3216Metric
C604, C606: 15n; C_0603_1608Metric; Voltage 35V
C605: 100n; C_0603_1608Metric; Voltage 10V
C607, C609: 10u; C_1206_3216Metric; Voltage 35v
C608: 100n; C_0603_1608Metric; Voltage 6V3
C610, C612: 22u; C_1206_3216Metric; Voltage 6V3
C611, C613: 4.7u; C_0603_1608Metric; Voltage 10V
C614, C615: 0.22u; C_0603_1608Metric; Voltage 6.3V
C617: 1u; C_0603_1608Metric; Voltage 25V
C618, C619: 47u; C_1210_3225Metric; Voltage 25V (16V)
D601: BATT_S_LED 5mm Horiz.; LED_D5.0mm_Horizontal_O3.81mm_Z3.0mm
D602: SMAJ15A
D603, D605: VSSAF3L45HM3_A/I; VSSAF3L45HM3
D604: 3V3_LED; LED_0805_2012Metric
F601: MF-LSMF075X; Bourns_MF-LSMF
JP601, JP602, JP603, JP604: SolderJumper_3_Bridged12; SolderJumper-3_P1.3mm_Open_RoundedPad1.0x1.5mm_NumberLabels
L601: 3.3u; LAITS_L_Bourns_SRP7028A_7.3x6.6mm
L602: 1.5u; LAITS_L_Coilcraft_XxL4040; Current Rating 5A Isat
R601, R604, R610, R612, R614: 10k; R_0603_1608Metric
R602: 330R; R_0603_1608Metric
R603, R622, R623: 100k; R_0603_1608Metric
R605, R609: 10R; R_0603_1608Metric
R606: 31.6k; R_0603_1608Metric; Tolerance 1%
R607: 10k; R_0603_1608Metric; Tolerance 1%
R608: 10m; R_1206_3216Metric
R611, R613: 200k; R_0603_1608Metric
R615: 510R; R_0603_1608Metric
R616: 4.7R; R_0603_1608Metric
R617: 0R BUCK TEST; R_1206_3216Metric
R618: 178k; R_0603_1608Metric
R619: DNP; R_0603_1608Metric
R620: 86.6k; R_0603_1608Metric
R621: 54.9k; R_0603_1608Metric
SW601: SW_SPDT; OS102011MA1QN1
TH601: NTC; R_0603_1608Metric
U601: NCV8164ASN180T1G
U602: AP62301WU-7; TSOT-23-6
U603: MAX77960BEFV12+; Manufacturer_Part_Number MAX77960EFV06+; Mouser Part Number 700-MAX77960EFV06+

Connections:
+1V8: C603.1, R603.1, U601.5 (VOUT); also elsewhere on the board
+3V3: C601.1, D604.2 (A), R601.1, R602.1, R617.2, U601.1 (VIN); also elsewhere on the board
+BATT: BT601.C2+, C616.1, D605.2 (A), U603.11 (BATSP), U603.12 (BATT_1); also elsewhere on the board
/AUX + Peripherals/SCL1: U603.14 (SCL); also elsewhere on the board
/AUX + Peripherals/SDA1: U603.15 (SDA); also elsewhere on the board
/BATT + POWER/1V8_EN: R601.2, U601.3 (EN)
/BATT + POWER/AVL: C613.1, R616.2, R622.1, U603.26 (AVL)
/BATT + POWER/B1-B2: BT601.C1+, BT601.C2-
/BATT + POWER/BST1: C614.1, U603.1 (BST1)
/BATT + POWER/BST2: C615.1, U603.9 (BST2)
/BATT + POWER/CHGIN: C607.1, C609.1, R608.2, R609.1, U603.2 (CHGIN)
/BATT + POWER/CSINN: C605.2, C606.2, R609.2, U603.30 (CSINN)
/BATT + POWER/CSINP: C604.2, C605.1, R605.2, U603.29 (CSINP)
/BATT + POWER/DISQBAT: R612.1, U603.8 (DISQBAT)
/BATT + POWER/EN: SW601.2 (B), U602.5 (EN)
/BATT + POWER/FUSE_OUT: D602.1 (A1), D603.2 (A), F601.1
/BATT + POWER/INLIM: JP601.2 (C), U603.21 (INLIM)
/BATT + POWER/INLIM_R: JP601.1 (A), R621.1
/BATT + POWER/ISET: JP603.2 (C), U603.23 (ISET)
/BATT + POWER/ISET_R: JP603.3 (B), R619.1
/BATT + POWER/ITO: JP604.2 (C), U603.25 (ITO)
/BATT + POWER/ITO_R: JP604.1 (A), R618.1
/BATT + POWER/LX1: C614.2, L602.1, U603.3 (LX1)
/BATT + POWER/LX2: C615.2, L602.2, U603.5 (LX2)
/BATT + POWER/MAX_INOKB: R611.2, U603.17 (INOKB); also elsewhere on the board
/BATT + POWER/MAX_INTB: R604.2, U603.18 (INTB); also elsewhere on the board
/BATT + POWER/OTGEN: R614.1, U603.7 (OTGEN)
/BATT + POWER/PVL: C611.1, JP601.3 (B), JP602.3 (B), JP603.1 (A), JP604.3 (B), R604.1, R611.1, R613.1, R616.1, U603.22 (CNFG), U603.27 (PVL)
/BATT + POWER/STAT: R613.2, U603.16 (STAT)
/BATT + POWER/STBY: R610.1, U603.28 (STBY)
/BATT + POWER/SW_BST: C608.2, U602.4 (BST)
/BATT + POWER/SW_FB: R606.2, R607.1, U602.6 (FB)
/BATT + POWER/SW_NODE: C608.1, L601.1, U602.2 (SW)
/BATT + POWER/SW_NODE_OUT: C610.1, C612.1, L601.2, R606.1, R617.1
/BATT + POWER/SW_VIN: C602.1, D603.1 (K), R623.1, U602.1 (VIN)
/BATT + POWER/THM: R622.2, TH601.1, U603.13 (THM)
/BATT + POWER/VSET: JP602.2 (C), U603.24 (VSET)
/BATT + POWER/VSET_R: JP602.1 (A), R620.1
/BATT + POWER/~BATT_S_LED: D601.1 (K); also elsewhere on the board
GND: BT601.C1-, C601.2, C602.2, C603.2, C604.1, C606.1, C607.2, C609.2, C610.2, C611.2, C612.2, C613.2, C616.2, C617.2, C618.2, C619.2, D602.2 (A2), R607.2, R610.2, R612.2, R614.2, R615.2, R618.2, R619.2, R620.2, R621.2, SW601.3 (C), TH601.2, U601.2 (GND), U602.3 (GND), U603.4 (PGND), U603.10 (BATSN), U603.20 (GND); also elsewhere on the board
unnamed: D601.2 (A), R602.2
unnamed: D604.1 (K), R615.1
unnamed: R603.2, U601.4 (PG)
unnamed: R623.2, SW601.1 (A)
VBUS: R605.1, R608.1; also elsewhere on the board

Notes on the sheet:
ATT!
SGND
Battery Management
3V3 Switching
Battery
TVS VBR 17V IBR=1mA
3V3 Peripherals MAX absolute ratings: - ESP32 = 500mA (min required by DS) - GPIO Expander = 300mA (with all pin max output) - CP2102N = 50mA - 4 Sensors = 10mA - GPS/RTC = 70mA/50mA - Buzzer = 35mA -------------------------- TOT < 1.5A -> Real probably < 0.7A
PGND
1.5A Input max
If at least one has no valid resistor value (ISET) charging is disabled by default and need to be set by I2C (choosen for safety reasons).
Batt. Insertion Protection
Needed only if AS7341 used.
PD=Vin(Ignd(Iout))+Iout(Vin-Vout)= 3.3(0)+300m(3.3-1.8)=0.45 W
Even if Batt. is not present, VSYS is always regulated to VBATTREG (see datasheet).
There are also some proprietary protocols (e.g. Apple, Samsung and Blackberry chargers) that allows to draw more than 1.5A without USB C PD, but they are not implemented on CP2102N.
Led off batt normal, Led on batt charging, Led blinking slow batt low (in order to save energy).
Temp Protection
300mA max
8.4V
Tcold = 4.1 °C Thot = 53.2 °C
PDmax=(Tjmax-Ta)/R0JA)= (125-20)/158=0.66 W
USB BC 1.2 Imax = 1.5A.
WARNING, NO REVERSE POLARITY PROTECTION!
Max 1.5A
200mA top-off
The regulator always priorities the system, the remaining power will be delivered to battery if charging. So, if charging at 1.5A and system is using 1A, battery charger will get only 0.5A. If Input power is not enough to power the system, battery will output current to system. So, if available inp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
On/Off Switch. OBV battery rail remains active.
0.75A Hold 1.5A Trip
Battery Status LED
==>
As close as possible to battery terminals.
2S1P 18650 Li-Ion.
Low ESR
According to the DS of CP2102N, implementing USB BC 1.2, 1.5A is the TOTAL MAX CURRENT drawn from USB 5V rail.
1V8 Linear
According to the DS, VSYS swings from ABOUT VBATT to VBATTREG= termination voltage=8.4V (Set via I2C or VSET resistor), so from about 6.4 to 8.4

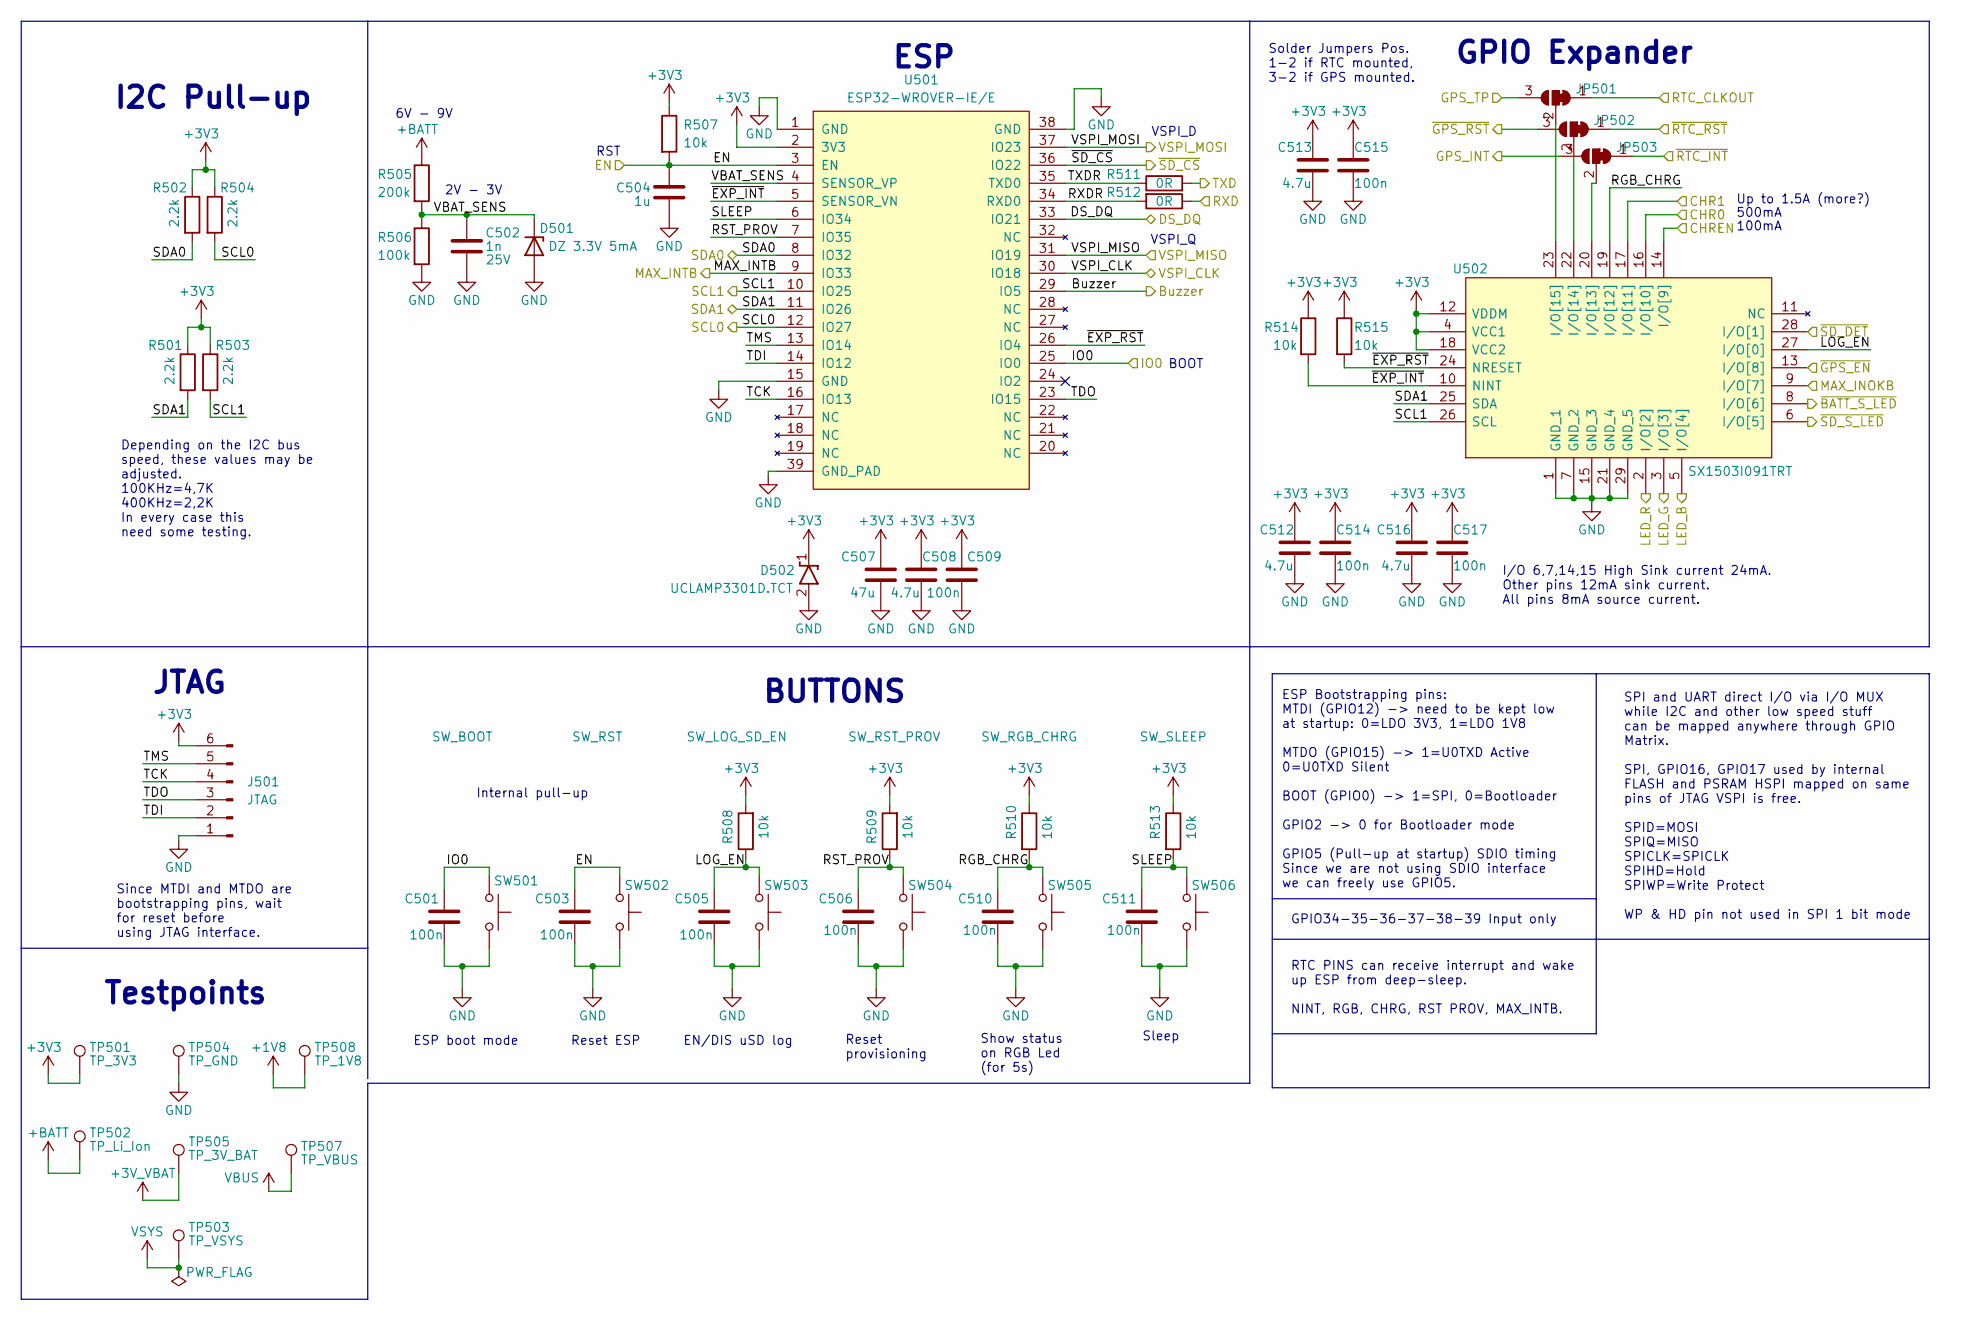
[picture p39: schematic ESP.kicad_sch]

Parts:
C501, C503, C505, C506, C509, C510, C511, C514, C515, C517: 100n; C_0603_1608Metric
C502: 1n; C_0603_1608Metric; Voltage Rating 25V
C504: 1u; C_0603_1608Metric
C507: 47u; C_1210_3225Metric
C508, C512, C513, C516: 4.7u; C_0603_1608Metric
D501: DZ 3.3V 5mA; D_SOD-923
D502: UCLAMP3301D.TCT; D_SOD-323
J501: JTAG; JST_B6B-XH-A
JP501, JP502, JP503: SolderJumper_3_Bridged12; SolderJumper-3_P1.3mm_Open_RoundedPad1.0x1.5mm_NumberLabels
R501, R502, R503, R504: 2.2k; R_0603_1608Metric
R505: 200k; R_0603_1608Metric
R506: 100k; R_0603_1608Metric
R507, R508, R509, R510, R513, R514, R515: 10k; R_0603_1608Metric
R511, R512: 0R; R_0603_1608Metric
SW501: SW_BOOT; SW_Tactile_SPST_Angled_PTS645Vx83-2LFS
SW502: SW_RST; SW_Tactile_SPST_Angled_PTS645Vx83-2LFS
SW503: SW_LOG_SD_EN; SW_Tactile_SPST_Angled_PTS645Vx83-2LFS
SW504: SW_RST_PROV; SW_Tactile_SPST_Angled_PTS645Vx83-2LFS
SW505: SW_RGB_CHRG; SW_Tactile_SPST_Angled_PTS645Vx83-2LFS
SW506: SW_SLEEP; SW_Tactile_SPST_Angled_PTS645Vx83-2LFS
TP501: TP_3V3; TestPoint_THTPad_D1.5mm_Drill0.7mm
TP502: TP_Li_Ion; TestPoint_THTPad_D1.5mm_Drill0.7mm
TP503: TP_VSYS; TestPoint_THTPad_D1.5mm_Drill0.7mm
TP504: TP_GND; TestPoint_THTPad_D1.5mm_Drill0.7mm
TP505: TP_3V_BAT; TestPoint_THTPad_D1.5mm_Drill0.7mm
TP507: TP_VBUS; TestPoint_THTPad_D1.5mm_Drill0.7mm
TP508: TP_1V8; TestPoint_THTPad_D1.5mm_Drill0.7mm
U501: ESP32-WROVER-IE/E; ESP32-WROVER-IE
U502: SX1503I091TRT

Connections:
+1V8: TP508.1; also elsewhere on the board
+3V0: TP505.1; also elsewhere on the board
+3V3: C507.1, C508.1, C509.1, C512.1, C513.1, C514.1, C515.1, C516.1, C517.1, D502.1, J501.6, R501.1, R502.1, R503.1, R504.1, R507.1, R508.2, R509.2, R510.1, R513.1, R514.1, R515.1, TP501.1, U501.2 (3V3), U502.4 (VCC1), U502.12 (VDDM), U502.18 (VCC2); also elsewhere on the board
+BATT: R505.1, TP502.1; also elsewhere on the board
/AUX + Peripherals/GPS_EXTINT: JP503.3 (B); also elsewhere on the board
/AUX + Peripherals/GPS_TP: JP501.3 (B); also elsewhere on the board
/AUX + Peripherals/LED_B: U502.5 (I/O[4]); also elsewhere on the board
/AUX + Peripherals/LED_G: U502.3 (I/O[3]); also elsewhere on the board
/AUX + Peripherals/LED_R: U502.2 (I/O[2]); also elsewhere on the board
/AUX + Peripherals/RTC_CLKOUT: JP501.1 (A); also elsewhere on the board
/AUX + Peripherals/SCL0: R502.2, U501.8 (IO32); also elsewhere on the board
/AUX + Peripherals/SCL1: R503.2, U501.10 (IO25), U502.26 (SCL); also elsewhere on the board
/AUX + Peripherals/SDA0: R504.2, U501.12 (IO27); also elsewhere on the board
/AUX + Peripherals/SDA1: R501.2, U501.11 (IO26), U502.25 (SDA); also elsewhere on the board
/AUX + Peripherals/VSPI_CLK: U501.30 (IO18); also elsewhere on the board
/AUX + Peripherals/VSPI_MISO: U501.31 (IO19); also elsewhere on the board
/AUX + Peripherals/VSPI_MOSI: U501.37 (IO23); also elsewhere on the board
/AUX + Peripherals/~GPS_EN: U502.13 (I/O[8]); also elsewhere on the board
/AUX + Peripherals/~GPS_RESET: JP502.3 (B); also elsewhere on the board
/AUX + Peripherals/~RTC_INT: JP503.1 (A); also elsewhere on the board
/AUX + Peripherals/~RTC_RST: JP502.1 (A); also elsewhere on the board
/AUX + Peripherals/~SD_CS: U501.36 (IO22); also elsewhere on the board
/AUX + Peripherals/~SD_DET: U502.28 (I/O[1]); also elsewhere on the board
/AUX + Peripherals/~SD_S_LED: U502.6 (I/O[5]); also elsewhere on the board
/BATT + POWER/MAX_INOKB: U502.9 (I/O[7]); also elsewhere on the board
/BATT + POWER/MAX_INTB: U501.9 (IO33); also elsewhere on the board
/BATT + POWER/~BATT_S_LED: U502.8 (I/O[6]); also elsewhere on the board
/ESP/Buzzer: U501.29 (IO5); also elsewhere on the board
/ESP/DS_DQ: U501.33 (IO21); also elsewhere on the board
/ESP/EN: C503.2, C504.1, R507.2, SW502.1, U501.3 (EN); also elsewhere on the board
/ESP/IO0: C501.2, SW501.1, U501.25 (IO0); also elsewhere on the board
/ESP/LOG_EN: C505.2, R508.1, SW503.1, U502.27 (I/O[0])
/ESP/RGB_CHRG: C510.2, R510.2, SW505.1, U502.19 (I/O[12])
/ESP/RST_PROV: C506.2, R509.1, SW504.1, U501.7 (IO35)
/ESP/RXDR: R512.2, U501.34 (RXD0)
/ESP/SLEEP: C511.2, R513.2, SW506.1, U501.6 (IO34)
/ESP/TCK: J501.4, U501.16 (IO13)
/ESP/TDI: J501.2, U501.14 (IO12)
/ESP/TDO: J501.3, U501.23 (IO15)
/ESP/TMS: J501.5, U501.13 (IO14)
/ESP/TXDR: R511.1, U501.35 (TXD0)
/ESP/VBAT_SENS: C502.1, D501.1 (K), R505.2, R506.1, U501.4 (SENSOR_VP)
/ESP/~EXP_INT: R514.2, U501.5 (SENSOR_VN), U502.10 (NINT)
/ESP/~EXP_RESET: R515.2, U501.26 (IO4), U502.24 (NRESET)
/USB/CHR0: U502.16 (I/O[10]); also elsewhere on the board
/USB/CHR1: U502.17 (I/O[11]); also elsewhere on the board
/USB/CHREN: U502.14 (I/O[9]); also elsewhere on the board
/USB/RXD: R512.1; also elsewhere on the board
/USB/TXD: R511.2; also elsewhere on the board
GND: C501.1, C502.2, C503.1, C504.2, C505.1, C506.1, C507.2, C508.2, C509.2, C510.1, C511.1, C512.2, C513.2, C514.2, C515.2, C516.2, C517.2, D501.2 (A), D502.2, J501.1, R506.2, SW501.2, SW502.2, SW503.2, SW504.2, SW505.2, SW506.2, TP504.1, U501.1 (GND), U501.15 (GND), U501.38 (GND), U501.39 (GND_PAD), U502.1 (GND_1), U502.7 (GND_2), U502.15 (GND_3), U502.21 (GND_4), U502.29 (GND_5); also elsewhere on the board
unnamed: JP501.2 (C), U502.23 (I/O[15])
unnamed: JP502.2 (C), U502.22 (I/O[14])
unnamed: JP503.2 (C), U502.20 (I/O[13])
VBUS: TP507.1; also elsewhere on the board

Notes on the sheet:
Reset provisioning
BUTTONS
RST
Depending on the I2C bus speed, these values may be adjusted. 100KHz=4,7K 400KHz=2,2K In every case this need some testing.
JTAG
Up to 1.5A (more?)
I2C Pull-up
BOOT
ESP boot mode
100mA
ESP Bootstrapping pins: MTDI (GPIO12) -> need to be kept low at startup: 0=LDO 3V3, 1=LDO 1V8 MTDO (GPIO15) -> 1=U0TXD Active 0=U0TXD Silent BOOT (GPIO0) -> 1=SPI, 0=Bootloader GPIO2 -> 0 for Bootloader mode GPIO5 (Pull-up at startup) SDIO timing Since we are not using SDIO interface we can freely 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
EN/DIS uSD log
Testpoints
6V - 9V
RTC PINS can receive interrupt and wake up ESP from deep-sleep. NINT, RGB, CHRG, RST PROV, MAX_INTB.
GPIO Expander
Reset ESP
VSPI_D
I/O 6,7,14,15 High Sink current 24mA. Other pins 12mA sink current. All pins 8mA source current.
Since MTDI and MTDO are bootstrapping pins, wait for reset before using JTAG interface.
500mA
Show status on RGB Led (for 5s)
Sleep
ESP
2V - 3V
Internal pull-up
Solder Jumpers Pos. 1-2 if RTC mounted, 3-2 if GPS mounted.
SPI and UART direct I/O via I/O MUX while I2C and other low speed stuff can be mapped anywhere through GPIO Matrix. SPI, GPIO16, GPIO17 used by internal FLASH and PSRAM HSPI mapped on same pins of JTAG VSPI is free. SPID=MOSI SPIQ=MISO SPICLK=SPICLK SPIHD=Hold SPIWP=Write Protect WP & HD pin not us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
VSPI_Q
GPIO34-35-36-37-38-39 Input only

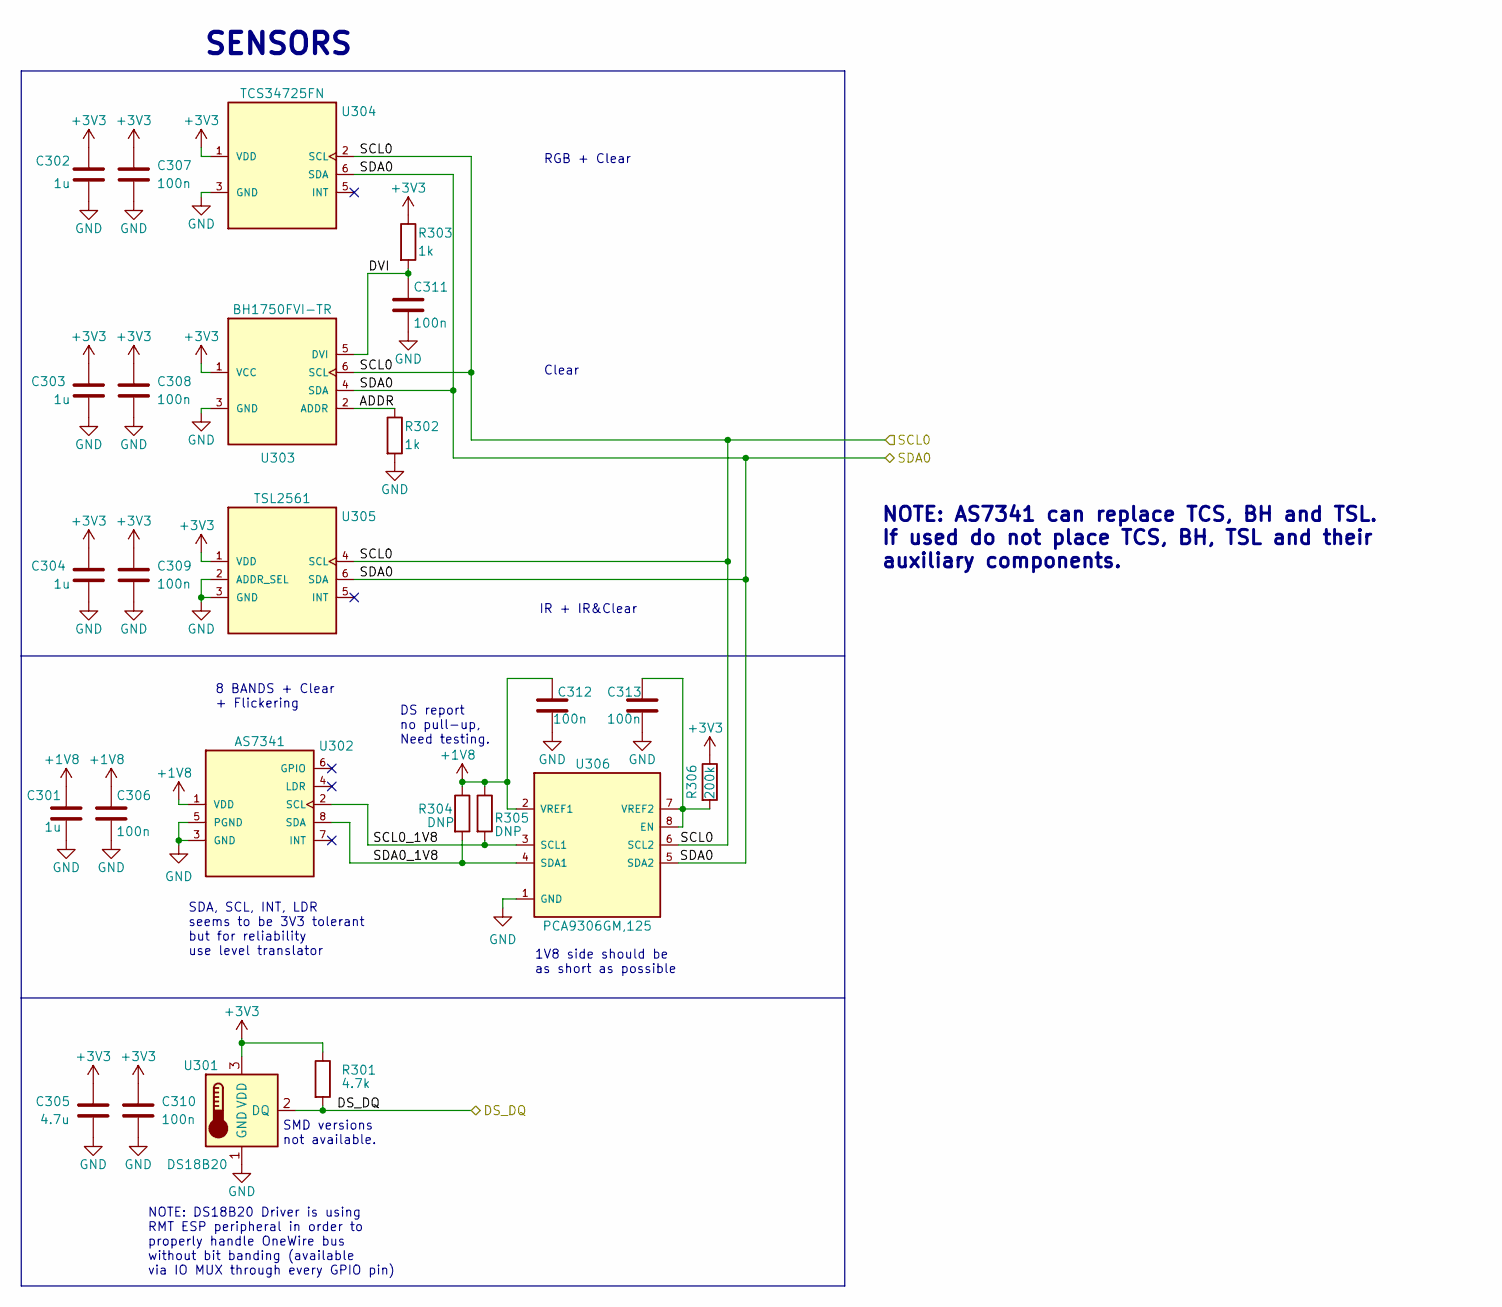
[picture p40: schematic Sensors.kicad_sch]

Parts:
C301, C302, C303, C304: 1u; C_0603_1608Metric
C305: 4.7u; C_0603_1608Metric
C306, C307, C308, C309, C310, C311, C312, C313: 100n; C_0603_1608Metric
R301: 4.7k; R_0603_1608Metric
R302, R303: 1k; R_0603_1608Metric
R304, R305: DNP; R_0603_1608Metric
R306: 200k; R_0603_1608Metric
U301: DS18B20; DS18B20 Hor.
U302: AS7341; AS7431
U303: BH1750FVI-TR
U304: TCS34725FN
U305: TSL2561
U306: PCA9306GM,125; PCA9306GM; Manufacturer_Part_Number PCA9306GM,125; Mouser Part Number 771-PCA9306GM125

Connections:
+1V8: C301.1, C306.1, C312.1, R304.1, R305.1, U302.1 (VDD), U306.2 (VREF1); also elsewhere on the board
+3V3: C302.1, C303.1, C304.1, C305.1, C307.1, C308.1, C309.1, C310.1, R301.1, R303.1, R306.1, U301.3 (VDD), U303.1 (VCC), U304.1 (VDD), U305.1 (VDD); also elsewhere on the board
/AUX + Peripherals/SCL0: U303.6 (SCL), U304.2 (SCL), U305.4 (SCL), U306.6 (SCL2); also elsewhere on the board
/AUX + Peripherals/SDA0: U303.4 (SDA), U304.6 (SDA), U305.6 (SDA), U306.5 (SDA2); also elsewhere on the board
/ESP/DS_DQ: R301.2, U301.2 (DQ); also elsewhere on the board
/Sensors/ADDR: R302.1, U303.2 (ADDR)
/Sensors/DVI: C311.1, R303.2, U303.5 (DVI)
/Sensors/SCL0_1V8: R305.2, U302.2 (SCL), U306.3 (SCL1)
/Sensors/SDA0_1V8: R304.2, U302.8 (SDA), U306.4 (SDA1)
GND: C301.2, C302.2, C303.2, C304.2, C305.2, C306.2, C307.2, C308.2, C309.2, C310.2, C311.2, C312.2, C313.2, R302.2, U301.1 (GND), U302.3 (GND), U302.5 (PGND), U303.3 (GND), U304.3 (GND), U305.2 (ADDR_SEL), U305.3 (GND), U306.1 (GND); also elsewhere on the board
unnamed: C313.1, R306.2, U306.7 (VREF2), U306.8 (EN)

Notes on the sheet:
RGB + Clear
Clear
1V8 side should be as short as possible
NOTE: AS7341 can replace TCS, BH and TSL. If used do not place TCS, BH, TSL and their auxiliary components.
IR + IR&Clear
SDA, SCL, INT, LDR seems to be 3V3 tolerant but for reliability use level translator
8 BANDS + Clear + Flickering
DS report no pull-up, Need testing.
SMD versions not available.
SENSORS
NOTE: DS18B20 Driver is using RMT ESP peripheral in order to properly handle OneWire bus without bit banding (available via IO MUX through every GPIO pin)
