tollsimy/LAITS-HW/ICCI-HW/ICCI-HW.kicad_pcb

## KiCad design ICCI-HW/ICCI-HW.kicad_pcb (continued)

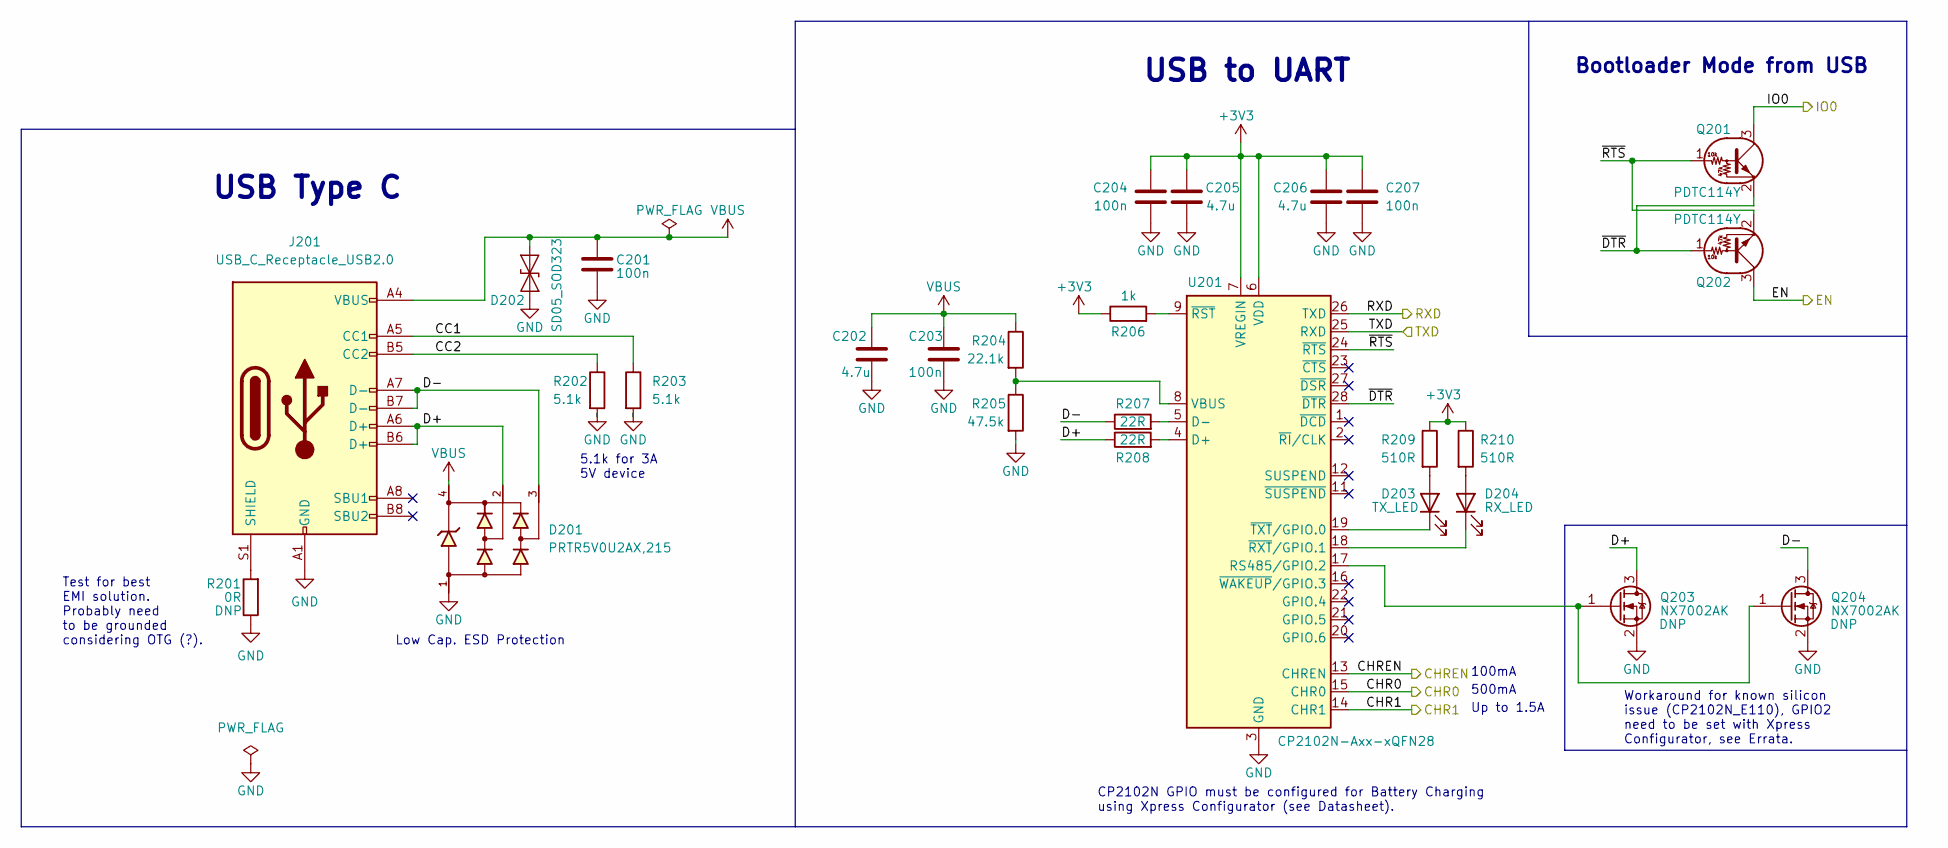
[picture p41: schematic USB.kicad_sch, PS + USB]

Parts:
C201, C203, C204, C207: 100n; C_0603_1608Metric
C202, C205, C206: 4.7u; C_0603_1608Metric
D201: PRTR5V0U2AX,215; SOT-143
D202: SD05_SOD323; D_SOD-323
D203: TX_LED; LED_0805_2012Metric
D204: RX_LED; LED_0805_2012Metric
J201: USB_C_Receptacle_USB2.0; USB_C_Receptacle_Amphenol_12401548E4-2A
Q201, Q202: PDTC114Y; SOT-23
Q203, Q204: NX7002AK; SOT-23
R201: 0R; R_0603_1608Metric
R202, R203: 5.1k; R_0603_1608Metric
R204: 22.1k; R_0603_1608Metric
R205: 47.5k; R_0603_1608Metric
R206: 1k; R_0603_1608Metric
R207, R208: 22R; R_0603_1608Metric
R209, R210: 510R; R_0603_1608Metric
U201: CP2102N-Axx-xQFN28; QFN-28-1EP_5x5mm_P0.5mm_EP3.35x3.35mm

Connections:
+3V3: C204.1, C205.1, C206.1, C207.1, R206.1, R209.1, R210.1, U201.6 (VDD), U201.7 (VREGIN); also elsewhere on the board
/ESP/EN: Q202.3 (C); also elsewhere on the board
/ESP/IO0: Q201.3 (C); also elsewhere on the board
/USB/CC1: J201.A5 (CC1), R203.1
/USB/CC2: J201.B5 (CC2), R202.1
/USB/CHR0: U201.15 (CHR0); also elsewhere on the board
/USB/CHR1: U201.14 (CHR1); also elsewhere on the board
/USB/CHREN: U201.13 (CHREN); also elsewhere on the board
/USB/D+: D201.2, J201.A6 (D+), J201.B6 (D+), Q203.3 (D), R208.1
/USB/D-: D201.3, J201.A7 (D-), J201.B7 (D-), Q204.3 (D), R207.1
/USB/RXD: U201.26 (TXD); also elsewhere on the board
/USB/TXD: U201.25 (RXD); also elsewhere on the board
/USB/~DTR: Q201.2 (E), Q202.1 (B), U201.28 (~DTR)
/USB/~RTS: Q201.1 (B), Q202.2 (E), U201.24 (~RTS)
GND: C201.2, C202.2, C203.2, C204.2, C205.2, C206.2, C207.2, D201.1, D202.1 (A1), J201.A1 (GND), J201.A12 (GND), J201.B1 (GND), J201.B12 (GND), Q203.2 (S), Q204.2 (S), R201.1, R202.2, R203.2, R205.2, U201.3 (GND), U201.29 (GND); also elsewhere on the board
unnamed: D203.1 (K), U201.19 (~TXT/GPIO.0)
unnamed: D203.2 (A), R209.2
unnamed: D204.1 (K), U201.18 (~RXT/GPIO.1)
unnamed: D204.2 (A), R210.2
unnamed: J201.S1 (SHIELD), R201.2
unnamed: Q203.1 (G), Q204.1 (G), U201.17 (RS485/GPIO.2)
unnamed: R204.2, R205.1, U201.8 (VBUS)
unnamed: R206.2, U201.9 (~RST)
unnamed: R207.2, U201.5 (D-)
unnamed: R208.2, U201.4 (D+)
VBUS: C201.1, C202.1, C203.1, D201.4, D202.2 (A2), J201.A4 (VBUS), J201.A9 (VBUS), J201.B4 (VBUS), J201.B9 (VBUS), R204.1; also elsewhere on the board

Notes on the sheet:
Test for best EMI solution. Probably need to be grounded considering OTG (?).
Workaround for known silicon issue (CP2102N_E110), GPIO2 need to be set with Xpress Configurator, see Errata.
USB Type C
CP2102N GPIO must be configured for Battery Charging using Xpress Configurator (see Datasheet).
Bootloader Mode from USB
Low Cap. ESD Protection
USB to UART
500mA
Up to 1.5A
100mA
5.1k for 3A 5V device

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
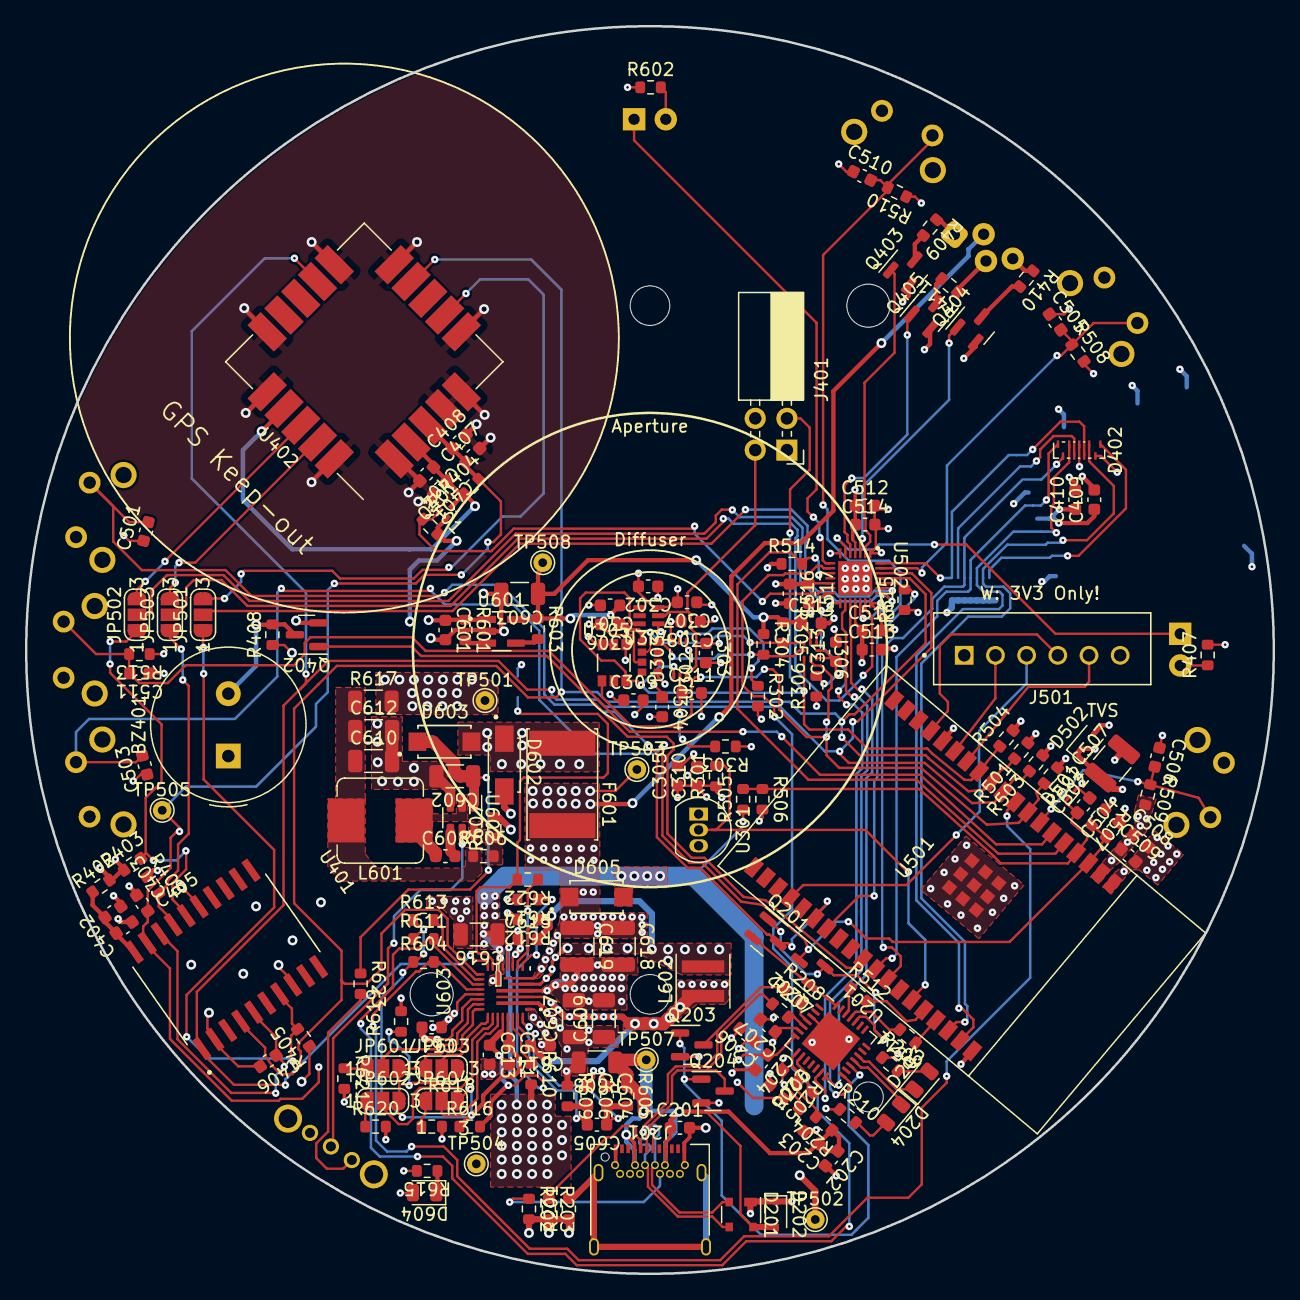
[picture p42: board ICCI-HW.kicad_pcb from above]

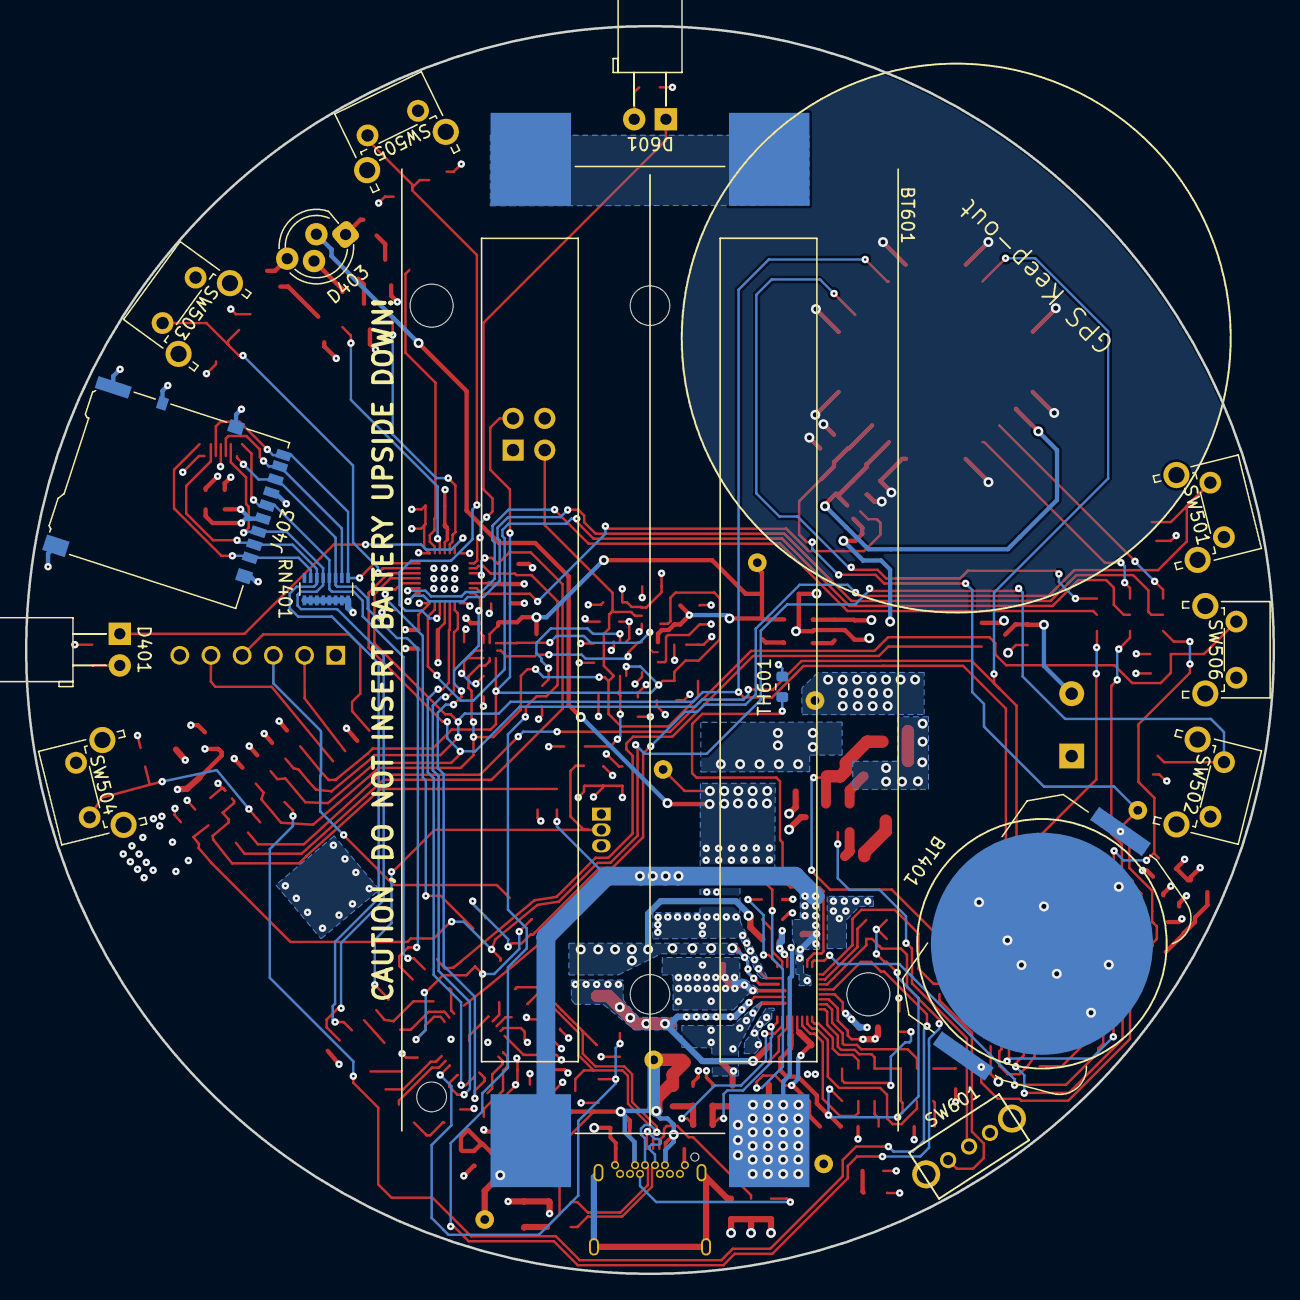
[picture p43: board ICCI-HW.kicad_pcb from below]

Board: 4 copper layers, 100.0 x 100.0 mm, 201 parts (15 on the bottom side), 125 nets.
