tollsimy/LAITS-HW/(commit log)

2022-05-10 rtc + sensors
    [Aux_peripherals.kicad_sch, BATT.kicad_sch, ESP.kicad_sch, ICCI-HW.kicad_sch, PS_USB.kicad_sch, Sensors.kicad_sch]
2022-05-11 usb PD started
    [Aux_peripherals.kicad_sch, BATT+POWER.kicad_sch, ICCI-HW.kicad_sch, Sensors.kicad_sch, USB.kicad_sch]
2022-05-20 add GPIO Expansion
    [Aux_peripherals.kicad_sch, BATT+POWER.kicad_sch, ESP.kicad_sch, ICCI-HW.kicad_sch, Sensors.kicad_sch]
2022-05-23 schematic V1.0
    [Aux_peripherals.kicad_sch, BATT+POWER.kicad_sch, ESP.kicad_sch, ICCI-HW.kicad_sch, Sensors.kicad_sch, USB.kicad_sch]
2022-05-23 footprint assigned
    [Aux_peripherals.kicad_sch, BATT+POWER.kicad_sch, ESP.kicad_sch, ICCI-HW.kicad_sch, Sensors.kicad_sch, USB.kicad_sch]
2022-05-23 start layout
    [ICCI-HW.kicad_pcb]
2022-05-23 change MAX77962 (BGA) to MAX77960B (FC2QFN)
    [BATT+POWER.kicad_sch, ICCI-HW.kicad_pcb, ICCI-HW.kicad_sch]
2022-05-31 fw: updates
    [Aux_peripherals.kicad_sch, BATT+POWER.kicad_sch, ESP.kicad_sch, ICCI-HW.kicad_pcb, ICCI-HW.kicad_sch, Progetto_mag29_0633.xls, Sensors.kicad_sch, USB.kicad_sch]
2022-07-15 hw: updates
    [Aux_peripherals.kicad_sch, BATT+POWER.kicad_sch, ESP.kicad_sch, ICCI-HW.kicad_pcb, ICCI-HW.kicad_sch, Progetto_mag29_0633.xls, Sensors.kicad_sch, USB.kicad_sch]
2022-07-22 layout updates
    [Aux_peripherals.kicad_sch, BATT+POWER.kicad_sch, ESP.kicad_sch, ICCI-HW.kicad_pcb, ICCI-HW.kicad_sch, Sensors.kicad_sch, USB.kicad_sch]
2022-07-25 layout PCB V1.0
    [Aux_peripherals.kicad_sch, BATT+POWER.kicad_sch, ESP.kicad_sch, ICCI-HW.kicad_sch, ICCI_Edge_Cuts_round.dxf, Sensors.kicad_sch, USB.kicad_sch, edges.dxf]
2022-07-26 hw: fix missing contact from SYS to SYSA on MAX77960
    [Aux_peripherals.kicad_sch, BATT+POWER.kicad_sch, ESP.kicad_sch, ICCI-HW.kicad_sch, Sensors.kicad_sch, USB.kicad_sch]
2022-07-26 change name from ICCI to LAITS
    [Aux_peripherals.kicad_sch, BATT+POWER.kicad_sch, ESP.kicad_sch, ICCI-HW.kicad_sch, LAITS-HW.kicad_sch, LAITS_Edge_Cuts_round.dxf, Sensors.kicad_sch, USB.kicad_sch]
2022-07-27 improved silkscreen placement and some minor changes
    [Aux_peripherals.kicad_sch, BATT+POWER.kicad_sch, ESP.kicad_sch, LAITS-HW.kicad_sch, Progetto_mag29_0633.xls, USB.kicad_sch]
2022-07-27 generate JLCPCB Gerber Outputs
    [LAITS-HW-B_Cu.gbl, LAITS-HW-B_Mask.gbs, LAITS-HW-B_Paste.gbp, LAITS-HW-B_Silkscreen.gbo, LAITS-HW-Edge_Cuts.gm1, LAITS-HW-F_Cu.gtl, LAITS-HW-F_Mask.gts, LAITS-HW-F_Paste.gtp]
2022-07-27 improved silkscreen and add JLCPCB Ordering Instructions
    [LAITS-HW-B_Cu.gbl, LAITS-HW-B_Mask.gbs, LAITS-HW-B_Paste.gbp, LAITS-HW-B_Silkscreen.gbo, LAITS-HW-Edge_Cuts.gm1, LAITS-HW-F_Cu.gtl, LAITS-HW-F_Mask.gts, LAITS-HW-F_Paste.gtp]
2022-07-28 fix USB trace clearance
    [LAITS-HW-B_Cu.gbl, LAITS-HW-B_Mask.gbs, LAITS-HW-B_Paste.gbp, LAITS-HW-B_Silkscreen.gbo, LAITS-HW-Edge_Cuts.gm1, LAITS-HW-F_Cu.gtl, LAITS-HW-F_Mask.gts, LAITS-HW-F_Paste.gtp]
2022-07-28 rename gerbers.zip
2022-08-01 add .step board file
2022-08-01 remove wrong inductor from BOM
    [Progetto_mag29_0633.xls]
2022-08-08 generate IBOM
    [BATT+POWER.kicad_sch, Sensors.kicad_sch, USB.kicad_sch]
2022-08-08 add BOM files
    [LAITS-HW.csv, LAITS-HW_RTC_AS7341_VER.csv]
2022-08-10 Patch 1.0.1
    Bug:
    - Changed U602 footprint from TSOT26 to SOT563 in order to reflect pin assignment.
    Small bugs:
    - Missing silkscreen for SMD leds info (3V3, RX, TX)
    - DS18B20 silkscreen now reflect horizontal placement
    - Rotated and modified the pinout of the jumper JP603 so now it's clear that it is connected different in respect to JP601, JP602, JP604
    - Made visible the dot for the placement of U602
    - Made visible dot for placement D603 and D605
    - Added I2C info on Silkscreen for I2C Pull-up resistors
    - Add info on Sch for USB-C Shield connection
    [Aux_peripherals.kicad_sch, BATT+POWER.kicad_sch, ESP.kicad_sch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]
2022-08-10 Updated BOM to patch 1.0.1
    [LAITS-HW.csv, LAITS-HW_RTC_AS7341_VER.csv]
2022-08-11 Fixed a minor bug in the assignment of SDA0 and SCL0 pins, doesn't affect Hardware, swap in firmware
    [Aux_peripherals.kicad_sch, BATT+POWER.kicad_sch, ESP.kicad_sch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]
2022-08-25 Now LAITS notify charge state also when turned off
    [Aux_peripherals.kicad_sch, BATT+POWER.kicad_sch, ESP.kicad_sch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]
2022-08-27 Marked C501 as DNP to ensure proper startup sequence
    [ESP.kicad_sch, LAITS-HW_RTC_AS7341_VER_NOGPS.csv]
2022-09-02 Add small info about ESP antenna selector on schematic
    [ESP.kicad_sch]
